AIYAA-1011/buhuiqiming_srm-car/docs/PPT文字索引.md

# 最终交付PPT文字索引

> 原件名为“不晦启明队_ 最终交付.pptx”，内含中期结构材料和过程页面。以下按原页序提取，保留历史表述，不作为最终实装或最终规则验收依据。最新状态见[最终交付说明](最终交付.md)。

## 第1页

结构组中期汇报

不晦启明队

结构组  顾翊天 周汐玥 
汇报进度截至 2026年10月16日

低矮麦轮底盘与折返机械臂

移动对位、矿石抓取与递交的结构方案

01 / 15

## 第2页

底盘整体布局

不晦启明队  结构组

电池

控制板

存矿区域

图示未完全配合，夹取舵机尚未收纳

碳纤维承载式底板

底板约250 × 310 × 5 mm
低矮布置，设计离地间隙约5 mm

电子器件尽量水平铺开

利用底盘平面空间，减少上下叠放
给主臂折叠和线束留出垂向空间

轮组与臂组共同布局

轴距约250 mm，肩部靠近作业侧后缘
控制板、电池与存矿区分开安排

结构组中期汇报

## 第3页

底板镂空与矿石避让

不晦启明队  结构组

肩轴中心

矿石靠近此侧

作业侧后缘

肩部中心靠近后缘，缩短向车外夹取的距离

1

2

3

4

1  电池绑带固定孔

穿过绑带，限制电池移动

2  舵机收纳孔

夹爪放平后，为下置舵机让位

3  控制板过线孔

线束穿板，便于控制板与执行器连接

4  弧形矿石避让口

R75弧口为矿石保留避让空间

结构组中期汇报

## 第4页

麦轮底盘的移动与对位

不晦启明队  结构组

04 / 15

向作业端前进

向左平移

逆时针转向

俯视图，三角标记为作业端

轮旁箭头表示各轮滚动驱动方向，反向运动时四轮箭头全部反向

结构组中期汇报

## 第5页

机械臂设计与关节运动

不晦启明队  结构组

05 / 15

R1 肩部俯仰

R2 肘部俯仰

R3 末端俯仰

R4 绕臂长轴自转

G1 夹取开合

夹持矿石中间细腰

删除底座回转

减少根部轴系和高度堆叠
车身转向部分承担朝向调整

肩肘舵盘直连

不另设外置带轮或齿轮减速级
主臂采用PLA打印主体

折返与末端自转收纳

将夹取舵机转入底盘凹槽
保留必要动作，控制占用空间

R1 / R2：主臂设计    R3 / R4 / G1：夹爪动作接口

结构组中期汇报

## 第6页

装配方式与顺序

不晦启明队  结构组

06 / 15

01 电机固定板

02 肩部舵盘

03 爪组接口

01  底板与轮组

按计划攻丝后锁螺钉
先定位电机固定板，再装轮组

02  肩根与双轴舵机

安装肩部固定块，校正转轴方向
主、副舵盘连接两侧臂板

03  肘部与夹爪接口

先调舵机零位，再锁紧臂段
接入爪组，检查全行程避让

04  复查与动作验证

螺纹与防松、同轴性、轮组方向
线束余量和低速空载动作

结构组中期汇报

## 第7页

过洞收纳与通行

不晦启明队  结构组

07 / 15

点击视频播放  无声

结构组中期汇报

## 第8页

不同矿石姿态的夹取

不晦启明队  结构组

08 / 15

1

竖立与侧躺工况

2

都夹持中间细腰

3

侧躺时上方接近

4

抬升并收回

点击视频播放  无声

结构组中期汇报

## 第9页

一二三级兑换姿态

不晦启明队  结构组

09 / 15

1

矿石固定在爪内

2

腕部俯仰联动

3

车身调整方位

4

吸附松爪后退出

点击视频播放  无声

结构组中期汇报

## 第10页

分工、进度与后续安排

不晦启明队  结构组

10 / 15

实物展示

截至10月16日

全部零件已加工
整车部分装配（一些零件配不上稍作更改）
功能尚未实机验证

顾翊天

底盘、主臂及其余结构
零件采购与装配

周汐玥

夹爪夹取、旋转与俯仰三轴
夹爪机构装配

后续计划

辅助电控组调试并完成组装

结构组中期汇报

## 第11页

三种姿态与尺寸边界

答辩备份

11 / 15

开局收纳

约371 × 388 × 151 mm

过洞收纳

收纳高度小于70 mm

作业姿态

肩肘展开，末端按任务对位

规则边界：初始400 × 400 × 400 mm，伸展800 × 800 × 800 mm，整车≤6 kg

新收纳高度小于70 mm由队员确认；开局尺寸另为旧CAD几何候选，需装配复核。

结构组中期汇报

## 第12页

底板与关节连接细节

答辩备份

12 / 15

底板孔位与局部镂空

计划连接方式

碳板直接攻丝后锁螺钉
电机固定板与肩部固定块先定位
双轴舵机主、副舵盘连接两侧臂板

装配时重点复查

转轴方向与两侧连接是否同轴
舵盘锁紧前是否完成初始位置校正
碳板螺纹的承载、边距与防松
打印孔位、舵机壳体与线束避让

图示孔位来自CAD，实际锁紧与防松能力需装配确认。

结构组中期汇报

## 第13页

关节范围与舵机选型假设

答辩备份

13 / 15

关节 | 选型与角度 | 静态重力矩估算 | 名义换算 条件值

肩部俯仰 | 30等级 270° | 1.30–1.48 N·m | 2.94 N·m

肘部俯仰 | 25等级 270° | 0.79–0.90 N·m | 2.45 N·m

末端三轴 | 15等级 标注360° | 本页不作独立校核 | 角度标注不等于无限回转

估算前提

矿石20 g；PLA密度1.24 g/cm³
有效打印体积取65%至100%作敏感性比较
大舵机按75 g、小舵机按60 g估计

结论边界

若30 / 25的单位为kgf·cm，才作表中换算
未计加速度、冲击、摩擦及全部紧固件
静态估算不能证明连续工作与结构可靠性

结构组中期汇报

## 第14页

开源借鉴与再设计归类

答辩备份

14 / 15

充分再设计

删除底座回转轴
肩肘舵盘直连，精简传动

非充分再设计

轮距、轴距调整
电子器件平铺与执行器选型

无效再设计

碳纤维底板选材
PLA打印主体与外形适配

参考串联堆叠与折叠布局，没有直接照搬零件或完整尺寸

结构组中期汇报

## 第15页

兑换条件与可达性核对

答辩备份

15 / 15

难度 | z mm | θ ° | φ ° | 单次得分 | 解锁条件

一级 | 280.5 | 90 | 90 | 1 | 无需解锁

二级 | 100–200 | 30–60 | 90 | 10 | 一级完成1次

三级 | 100–200 | 30–60 | 90–120 | 20 | 二级累计完成2次

动画采用的代表位姿

一级 280.5 / 90 / 90
二级 200 / 45 / 90
三级 200 / 45 / 105

完成兑换的关键条件

裁判宣布可以兑换后递矿
尾孔与圆柱配合，吸附后释放夹爪
随兑换站到达退矿位姿且不掉落才判成功

腕部俯仰联动，夹持点按CAD估算；接触与三维碰撞仍需实物验证。

结构组中期汇报

## 第16页

电控部分

## 第17页

图表 1 MCU

图表 2 电机驱动模块

电控部分

## 第18页

图表 1 MCU

图表 2 电机驱动模块

电控部分

车控采用：
stm32f103rct6

## 第19页

图表 1 MCU

图表 2 电机驱动模块

电控部分

车控采用：
stm32f103rct6

遥控采用：
stm32f103c8t6

均包含复位电路

## 第20页

图表 3 电源管理模块

图表 4 舵机驱动模块

电控部分

## 第21页

图表 3 电源管理模块

图表 4 舵机驱动模块

电控部分

图表 2 电机驱动模块

## 第22页

图表 3 电源管理模块

图表 4 舵机驱动模块

电控部分

图表 2 电机驱动模块

12V / 1800mAh电池

2mΩ采样电阻＋INA226

VM_12V母线

4×DRV8874

四个电机

2×XL4015

五个舵机

LM2596-5.0

STM32、nRF、INA226等

车控电源方案

12V->5V->3.3V

电池持续电流只有4A!!!

12V->6V

## 第23页

图表 3 电源管理模块

图表 4 舵机驱动模块

电控部分

图表 2 电机驱动模块

车控电源方案

电池持续电流只有4A!!!

## 第24页

图表 3 电源管理模块

图表 4 舵机驱动模块

电控部分

图表 2 电机驱动模块

车控电源方案

电池持续电流只有4A!!!

## 第25页

图表 3 电源管理模块

图表 4 舵机驱动模块

电控部分

图表 2 电机驱动模块

车控电源方案

电池持续电流只有4A!!!

## 第26页

图表 3 电源管理模块

图表 4 舵机驱动模块

电控部分

图表 2 电机驱动模块

## 第27页

图表 4 舵机驱动模块

电控部分

图表 2 电机驱动模块

30KG

25KG

MG945

MG945

MG945

机械臂选型：

汽车底盘

## 第28页

图表 4 舵机驱动模块

电控部分

图表 2 电机驱动模块

风险点：五只舵机不能同时快速启动
选型：PCA9685

可以输出多路舵机PWM。
只占用MCU两根I²C信号线。

## 第29页

图表 4 舵机驱动模块

电控部分

图表 2 电机驱动模块

四路电机独立驱动，可以分别进行速度闭环。

公共MOTOR_EN可以在急停或失联时快速关闭全部电机

## 第30页

图表 5 无线通讯模块

图表 6  oled模块

电控部分

通信选型：Si24R1

显示电压、电流、功率和剩余电量

## 第31页

图表 7 蜂鸣器和急停

图表 8 串口调试模块

电控部分

提示上电、失联、欠压和急停

通知MCU立即停止所有动作

## 第32页

图表 8 串口调试模块

电控部分

## 第33页

电控部分

## 第34页

电控部分

## 第35页
