AIYAA-1011/buhuiqiming_srm-car/software/P02_remote_hal/遥控器说明.md

# P02 遥控器 功能说明

| 项目 | 内容 |
|---|---|
| 工程名称 | `P02_remote_hal` |
| 设备类型 | 麦轮小车遥控器（手持端） |
| 主控 | STM32F103C8T6 |
| 软件平台 | STM32 HAL + FreeRTOS |
| 开发工具 | Keil MDK-ARM V5.32 |
| 文档版本 | v1.0 |
| 编码 | UTF-8 |

---

## 目录

1. [概述](#1-概述)
2. [硬件资源](#2-硬件资源)
3. [软件架构](#3-软件架构)
4. [功能说明](#4-功能说明)
5. [对外接口：无线数据帧](#5-对外接口无线数据帧)
6. [显示界面](#6-显示界面)
7. [操作流程](#7-操作流程)
8. [参数配置](#8-参数配置)
9. [调试接口](#9-调试接口)

---

## 1. 概述

本设备为麦轮小车系统的**手持遥控端**，负责采集操作者的摇杆与按键输入，经处理后通过 2.4G 无线链路发送至小车端。

**设计原则**

遥控器端仅完成「输入采集 → 数值归一化 → 打包发送」以及本机状态显示，**不承担任何运动学解算、关节映射与执行器限位**。此类计算由小车端依据本机发送的轴值与标志位完成。

**主要功能一览**

| 类别 | 功能 |
|---|---|
| 输入 | 4 轴摇杆采集、6 键非阻塞扫描 |
| 处理 | 归一化（分段）、极性修正、限幅、死区与重新拉伸 |
| 控制 | 底盘 / 机械臂模式切换、三个预设姿态、急停、夹爪 |
| 安全 | 回中解锁、急停冻结输出 |
| 校准 | 双层窗口中位校准、中位 Flash 持久化 |
| 通信 | 常驻发送、17 字节定长帧、约 90 Hz |
| 诊断 | 无线链路成功率统计、串口调试输出 |
| 显示 | 128×64 OLED 状态显示 |

---

## 2. 硬件资源

### 2.1 主控与时钟

| 项目 | 参数 |
|---|---|
| MCU | STM32F103C8T6，LQFP48，64 KB Flash / 20 KB SRAM |
| 系统时钟 | 72 MHz（HSE 8 MHz × PLL9） |
| ADC 时钟 | 12 MHz（PCLK2 / 6） |
| 调试接口 | SWD（PA13 / PA14） |

### 2.2 外设分配

| 外设 | 配置 | 用途 |
|---|---|---|
| ADC1 | 4 通道扫描、连续转换、12 位 | 摇杆采集 |
| DMA1_CH1 | 循环模式、半字、外设→存储器 | ADC 数据搬运（不占用 CPU） |
| SPI1 | 主机、全双工、8 位、9 Mbps、软件 NSS | SI24R1 无线模块 |
| USART1 | 115200 8N1 | 调试日志输出 |
| SysTick | 1 kHz | FreeRTOS 时基 |

> SPI1 使用了引脚重映射（`AFIO_MAPR`），实际引脚为 PB3 / PB4 / PB5。

### 2.3 引脚分配

**摇杆（模拟输入）**

| 轴 | 物理位置 | 引脚 | ADC 通道 |
|---|---|---|---|
| `ly` | 左摇杆 上下 | PA1 | ADC1_IN1 |
| `lx` | 左摇杆 左右 | PA6 | ADC1_IN6 |
| `ry` | 右摇杆 上下 | PA2 | ADC1_IN2 |
| `rx` | 右摇杆 左右 | PA3 | ADC1_IN3 |

**按键（输入，内部上拉，低电平有效）**

| 按键 | 引脚 |
|---|---|
| `UP` | PB11 |
| `DOWN` | PB14 |
| `LEFT` | PB13 |
| `RIGHT` | PB12 |
| `LEFT_X` | PB2 |
| `RIGHT_X` | PB10 |

**无线模块 SI24R1**

| 信号 | 引脚 |
|---|---|
| SCK / MISO / MOSI | PB3 / PB4 / PB5 |
| 片选 NSS | PA15 |
| 使能 CE | PB7 |

**OLED 显示（软件模拟 SPI）**

| 信号 | 引脚 |
|---|---|
| CS / SCLK / SDIN | PA4 / PA5 / PA7 |
| RST / DC | PB0 / PB1 |

**其他**

| 信号 | 引脚 | 说明 |
|---|---|---|
| 调试串口 TX / RX | PA9 / PA10 | 115200 8N1 |
| 电源管理键 | PB15 | 周期模拟按键，抑制 IP5305T 自动关机 |

---

## 3. 软件架构

### 3.1 任务划分

系统运行于 FreeRTOS（tick 频率 1000 Hz，`heap_4` 堆 12 KB，优先级 0~4）。

| 任务 | 周期 | 优先级 | 职责 |
|---|---|---|---|
| `power_task` | 3 s | 4 | 周期触发电源芯片按键，抑制自动关机 |
| `com_task` | 10 ms | 3 | 组帧并发送 |
| `key_task` | 20 ms | 2 | 按键扫描、命令状态维护、回中解锁判定 |
| `joy_task` | 20 ms | 2 | 摇杆采集与轴处理 |
| `oled_task` | 100 ms | 1 | 屏幕刷新 |

### 3.2 模块划分

| 层次 | 文件 | 职责 |
|---|---|---|
| 硬件接口层 | `Int_joystick.c` | 摇杆 ADC 采集（DMA） |
| | `Int_key.c` | 按键非阻塞扫描 |
| | `Int_SI24R1.c` | 无线模块驱动 |
| | `Int_IP5305T.c` | 电源管理 |
| | `Inf_OLED.c` / `Inf_font.c` | OLED 驱动与字库 |
| 应用层 | `App_process_data.c` | 轴处理链、中位校准与持久化 |
| | `App_command.c` | 按键事件 → 命令状态、回中解锁 |
| | `App_transmit_data.c` | 组帧、发送、链路统计 |
| | `App_display.c` | 界面刷新 |
| | `App_freeRTOS_Task.c` | 任务创建与调度 |
| 公共层 | `Com_debug.c` | 日志输出重定向 |
| | `Com_tool.c` | 通用工具函数 |

---

## 4. 功能说明

### 4.1 摇杆采集与轴处理

**采集**：ADC1 以 4 通道扫描 + 连续转换方式工作，转换结果由 DMA1_CH1 循环写入缓冲区 `adc_buff[4]`，全过程不占用 CPU。

**处理链**（每 20 ms 执行一次）：

| 步骤 | 处理 | 说明 |
|---|---|---|
| 1 | ADC → 命令值 | **以标定中位为锚点，两侧各自归一化**（见下） |
| 2 | 极性修正 | 由配置宏 `AXIS_INV_*` 决定是否反相 |
| 3 | 限幅 | 限制在 −500 ~ +500 |
| 4 | 死区 | 绝对值小于**该轴**死区半宽时输出 0（默认 `AXIS_DEADZONE`，`ly` 单独用 `AXIS_DEADZONE_LY`） |
| 5 | 死区外重新拉伸 | 使输出自 0 平滑增长，避免死区边缘跳变 |

**死区可以按轴单独设置**

| 宏 | 值 | 轴 |
|---|---|---|
| `AXIS_DEADZONE` | 50 | 默认值，`lx` / `ry` / `rx` 都用它 |
| `AXIS_DEADZONE_LY` | **100** | `ly`（左杆上下 = 机械臂大臂）单独加大 |

`ly` 单独加大的原因：这根杆回中的一致性比其它轴差一些，死区太小时松手后大臂会自己慢慢爬。

**加大的代价只是"中位附近一段行程不响应"**——死区外会重新拉伸，所以**推到底仍然是满量程 ±500，不会丢极速**，只是中段手感变"钝"。实测（`raw_mid=1974`、`raw 0..4020`）：

| 死区 | 死区宽度（原始 ADC 计数） | 推到底 | 60% 行程时的输出 |
|---|---|---|---|
| 50 | 201 / 208 | ±500 | +277 |
| **100** | **398 / 413** | ±500 | **+250** |
| 150 | 596 / 617 | ±500 | +214 |
| 200 | 793 / 822 | ±500 | +166 |
| 300 | 1188 / 1231 | ±500 | +0（要推过 60% 才开始有输出） |

所以**不要超过 200 左右**，再大就变成"大半段行程没反应"了。

**第 1 步的分段归一化**

```c
正方向： raw_mid -> raw_lo   映射到   0 -> +500
负方向： raw_mid -> raw_hi   映射到   0 -> -500
```

- `raw_mid` 是校准得到的**中位**原始 ADC
- `raw_lo` / `raw_hi` 是**实测自学习**得到的两个端点原始 ADC（见 [4.8.1](#481-端点自学习)）

> **为什么不做成"整量程线性换算 −500~+500，再减一个零偏"**：那种做法只能把整条曲线**平移**。中位一旦偏离电气中点（2048），偏的那一侧就被白白吃掉一截量程——实测中位 1974 时正半轴只能到 **+480**，而负半轴被限幅削到 −500 反而看不出问题。
>
> **为什么端点也不能写死成 0 / 4095**：电位器不一定真能推到 ADC 的两条轨上。实测本机遥控器正方向 `raw` 能到 **0**，负方向只到 **约 4020**。端点写死 4095 的话，负方向最多只能到 **−480**。
>
> 中位和端点都用实测值之后，**不管中位落在哪里（1900 / 1974 / 2048 / 2100 …）、也不管电位器行程差多少，推到底都是精确的 ±500**，正反两个方向的灵敏度也对称。

**输出语义**

```
值域： −500 ~ +500
中位： 0（= 停止）
符号： 负值 = 反方向，正值 = 正方向
幅值： 速度 / 角速度的归一化大小
```

四个轴的输出存放于全局数组 `axis_value[4]`，顺序为 `ly / lx / ry / rx`。

### 4.2 按键输入

按键扫描为**非阻塞**实现：每 20 ms 读取一次全部 6 个引脚，拼装为位掩码返回，函数内部不含任何等待循环。

- **去抖**：要求连续 2 次读数一致
- **边沿检测**：由应用层计算上升沿（刚按下）与下降沿（刚松开）
- **长短按**：以按下时刻的时间戳判定，判定期间不阻塞其它按键

按键功能分配见下表：

| 按键 | 功能 | 触发方式 |
|---|---|---|
| `UP` | 急停 | 锁定式：按一下锁定，再按一下解除 |
| `LEFT` | 预设「过洞」 | 按一下触发，再按一下取消 |
| `RIGHT` | 预设「取矿」 | 同上 |
| `DOWN` | 预设「兑矿」 | 同上 |
| `LEFT_X` | 切换 底盘 / 机械臂 模式 | 按下即切换 |
| `RIGHT_X`（短按） | 夹爪开合 | 按下时长 < 1 s |
| `RIGHT_X`（长按） | 请求重新校准摇杆 | 按下时长 > 1 s |

### 4.3 控制模式

设备具有两种控制模式，由 `LEFT_X` 键切换：

| 模式 | 四个轴的语义 |
|---|---|
| **底盘模式** | `ry` 前后 / `rx` 左右 / `lx` 自转 / `ly`（不使用，固定发 0） |
| **机械臂模式** | `ly` 大臂 / `lx` 小臂 / `ry` 腕部俯仰 / `rx` 腕部转动 |

当前模式通过数据帧的标志位（bit2）发送。

### 4.4 预设姿态

提供三个预设姿态，均以**互斥锁存位**方式发送：

| 预设 | 触发键 |
|---|---|
| 过洞 | `LEFT` |
| 取矿 | `RIGHT` |
| 兑矿 | `DOWN` |

**启动条件**：当前没有其它预设处于激活状态。

**取消条件**（任一满足即清空预设位）：

1. 再次按下同一按键
2. 任意摇杆离开中位（操作员接管）
3. 按下急停
4. 解除急停

**互锁**：已经有预设时，按**别的**预设键**无效**——该次按键被忽略，同时屏幕行 1 最右一格的状态字母**闪烁 2 下**（约 800 ms）作为反馈。

必须先取消当前预设，才能启动另一个。取消的推荐方式是**按同一个键**；推摇杆虽然也能取消，但在机械臂模式下会同时让机械臂动作，不建议用来做"确认取消"。

> **为什么要互锁**：一个预设是一整套机械臂（和底盘）动作序列。若执行到一半被另一个预设顶掉，机械臂会从当前姿态直接拐向新轨迹，带着矿石时容易把矿甩掉或撞到结构。

**语义**：预设位为**电平**，每帧持续发送；接收侧依据 `0 → N`（开始执行）和 `N → 0`（中止）两种状态跳变识别意图。

由于互锁的存在，**正常操作下不会出现 `M → N` 的直接切换**（中间一定会经过全 0）。

### 4.5 急停

由 `UP` 键控制，采用**锁定式**语义：

| 状态 | 行为 |
|---|---|
| 激活（按一下） | 四个轴强制输出 0；预设位清空；预设按键不响应；屏幕显示反白字母 `E` |
| 解除（再按一下） | 清除急停位，同时进入「冻结」状态，要求摇杆回中后方可恢复输出 |

### 4.6 夹爪

由 `RIGHT_X` 短按翻转，状态通过标志位（bit1）以**电平**方式每帧发送。

### 4.7 回中解锁（安全机制）

**触发条件**：上电、切换模式、解除急停、请求重新校准。

**行为**：设备进入「冻结」状态，四个轴一律输出 0；待四个摇杆全部回到中位后自动解锁并恢复输出。

**设计目的**：避免模式切换瞬间将上一模式的摇杆位置当作新模式的命令发出。例如在底盘模式下持续前推右摇杆时切换至机械臂模式，若无此机制，腕部关节将按当前摇杆位置立即动作。

### 4.8 摇杆校准与中位持久化

**校准方式**：双层窗口判定

| 层次 | 条件 | 说明 |
|---|---|---|
| 第一层（精准） | 四个轴全部进入死区（屏幕显示 `----`） | 中位直接落在死区中心附近，效果最好 |
| 第二层（保底） | 进入冻结状态满 5 s 后仍未满足第一层，窗口放宽 | 防止电位器机械中位偏差过大时设备无法解锁 |

第二层进入时串口输出 `CALIB: wide window fallback`。

**校准流程**：连续采样 10 次（共约 100 ms）取平均，把得到的**原始 ADC** 定义为该轴中位，并写入 Flash 保存。

> 校准存的是**原始 ADC**（数值在 2000 附近），不是换算后的命令值。命令值域会随中位移动，只有原始 ADC 才是稳定的锚点。

**中位合法性检查**：四个轴的中位原始 ADC 必须全部落在 `AXIS_MID_MIN`(1300) ~ `AXIS_MID_MAX`(2750) 之间。

- 任一轴越界 → **本次校准整体拒绝**，不写 Flash、不解锁，串口输出 `CALIB REJECT: axis N mid=... 不在 [...] 内`，并重新开始 5 s 计时。
- 同时要求中位到两个端点的距离都不小于 `AXIS_MIN_HALF_RANGE`(600) 计数，否则报 `行程太短`。
- 从 Flash 读回时也做同样的检查；越界则视为无有效数据，要求重新校准。

范围取得比较宽，是为了不误伤"电位器机械中位本来就偏"的摇杆——宁可让某个轴的灵敏度左右略有差异，也不能让遥控器永远解不了锁。

#### 4.8.1 端点自学习

**为什么需要**：电位器的电气行程不一定铺满 ADC 的 0 ~ 4095，两端也可能不对称。实测本机遥控器：

| 方向 | 实测 `raw` 端点 |
|---|---|
| 正方向 | 能顶到 **0**（ADC 饱和） |
| 负方向 | 只到 **约 4020**，到不了 4095 |

所以端点必须在运行时实测。

**做法**：`joy_task` 每 20 ms 记录每个轴**真的见过**的最小 / 最大 `raw`，但只有"推得够深"才认账：

| 常量 | 值 | 含义 |
|---|---|---|
| `AXIS_END_LO_MAX` | 600 | 实测 `raw` 小于它，才算"正方向真的推到底了" |
| `AXIS_END_HI_MIN` | 3500 | 实测 `raw` 大于它，才算"负方向真的推到底了" |
| `AXIS_END_LO_DEFAULT` | 0 | 还没学到时的保底值 |
| `AXIS_END_HI_DEFAULT` | 4095 | 还没学到时的保底值 |
| `AXIS_WARMUP_SAMPLES` | 50 | 开机前 1 秒不学习（DMA 初值还是 0） |

生效端点 = 实测值（够深时）／保底值（不够深时）。护栏的作用是防止噪声或半程推杆把量程撑坏。

**持久化**：学到的极值会在**静默 2 秒后**自动写一次 Flash（`AXIS_END_SAVE_QUIET` = 100 拍）。只在已经成功校准过之后才会写；写一次标志就清零，加上 `calib_save()` 自身的内容比对，所以不会反复擦写。

> 所以正常情况下**不需要任何额外操作**：上电后推一两次杆顶到底，端点就学到了，并且会记住。

**中位持久化**

| 项目 | 内容 |
|---|---|
| 存储位置 | Flash 末页 `0x0800FC00`（1 KB 页，程序未占用） |
| 数据格式 | magic（2 B）+ 4 轴 × 3 个 int16（中位 / 见过的 min / 见过的 max，共 24 B）+ 异或校验（2 B） |
| 记录长度 | 14 个半字（28 B） |
| magic 值 | `0x5A5C` |
| 上电行为 | 读取有效则直接应用，跳过采样校准，端点也直接可用 |
| 写入时机 | 校准成功后；以及端点自学习到新极值后静默 2 秒 |
| 优化 | 数据与 Flash 中一致时跳过擦写 |

> **magic 变迁**：`0x5A5A`（最初的"命令域零偏"）→ `0x5A5B`（"原始 ADC 中位"，6 半字）→ **`0x5A5C`（"中位 + 两端点"，14 半字）**。不换 magic 的话旧数据会被按新格式误读，算出乱七八糟的量程。**所以每次升级格式后第一次上电都会要求重新校准一次，这是预期行为。**

### 4.9 无线通信

| 项目 | 内容 |
|---|---|
| 模块 | SI24R1（nRF24L01 兼容） |
| 工作模式 | **常驻发送**：上电配置一次，运行期间不再切换 |
| 通信方向 | 单向发送，不等待任何回复 |
| 同步要求 | 无（无需与接收端对齐周期或相位） |
| 发送周期 | 10 ms（含发送耗时，实际约 90 Hz） |

### 4.10 链路质量统计

利用无线模块的**硬件自动应答（Auto-ACK）**机制统计发送成功率：

- 每发送一帧，接收端无线芯片自动回复 ACK 包
- 发送函数返回成功即代表接收端已收到该帧
- 每 50 次发送结算一次，结果显示为屏幕上的 `LNK xx%`

该功能不增加任何额外通信开销，亦无需接收端软件配合。

> **适用边界**：ACK 由接收端的无线芯片产生，不依赖其主控程序，因此该指标反映「接收端无线模块在线且配置正确」，不能反映其主控运行状态。

### 4.11 电源管理

`power_task` 每 3 秒将电源管理芯片（IP5305T）的 KEY 引脚拉低 100 ms，模拟一次按键动作，抑制芯片的无操作自动关机。任务启动时立即执行一次，避免开机后等待首个周期期间被关机。

### 4.12 调试输出

调试日志通过 USART1（115200 8N1）输出，格式为 `[文件名:行号] 内容`。系统提供三级开关，详见[第 9 节](#9-调试接口)。

---

## 5. 对外接口：无线数据帧

### 5.1 无线参数

| 参数 | 值 |
|---|---|
| 通信地址 | `0x0A 0x01 0x06 0x1E 0x01`（5 字节） |
| 射频信道 | 40 |
| 空中速率 | 1 Mbps |
| 有效载荷宽度 | 17 字节 |
| CRC | 16 位使能 |
| 自动应答 | 通道 0 使能 |
| 自动重发 | 10 次，间隔 250 µs |

### 5.2 帧格式

**帧长固定 17 字节**，多字节字段均为**大端序**。

| 字节 | 字段 | 类型 | 说明 |
|---|---|---|---|
| `[0..2]` | 帧头 | — | `0x73 0x67 0x67`（`'s' 'g' 'g'`） |
| `[3..4]` | `ly` 左杆上下 | int16 | −500 ~ +500 |
| `[5..6]` | `lx` 左杆左右 | int16 | −500 ~ +500 |
| `[7..8]` | `ry` 右杆上下 | int16 | −500 ~ +500 |
| `[9..10]` | `rx` 右杆左右 | int16 | −500 ~ +500 |
| `[11]` | 命令标志位 | bitfield | 见 5.3 |
| `[12]` | 预留 | uint8 | 恒为 0 |
| `[13..16]` | 校验和 | uint32 | `[0..12]` 共 13 字节之和 |

**轴值说明**

- 有符号 16 位，负数以**二进制补码**表示，无偏置
- `0` 表示中位（停止），正负号表示方向
- 当设备处于**冻结**（未解锁）或**急停**状态时，四个轴一律为 0
- 底盘模式下 `ly` 固定为 0

### 5.3 命令标志位（byte 11）

| 位 | 名称 | 语义 |
|---|---|---|
| 0 | `ESTOP` | 1 = 急停锁定中 |
| 1 | `GRIPPER` | 1 = 夹爪夹紧，0 = 张开 |
| 2 | `MODE` | 0 = 底盘模式，1 = 机械臂模式 |
| 3 | `PRESET_HOLE` | 过洞 |
| 4 | `PRESET_PICK` | 取矿 |
| 5 | `PRESET_PUT` | 兑矿 |
| 6~7 | 保留 | — |

**约定**

- bit3 ~ bit5 **互斥**，同一时刻至多一位为 1；全 0 表示「无预设 / 已取消」
- 全部标志位均为**电平语义**：每帧发送当前完整状态，不做「发送后清零」
- 预设位依赖**状态跳变**被识别：`0 → N` 表示开始执行，`N → 0` 表示中止
- 由于遥控器端的互锁（见 [4.4](#44-预设姿态)），**接收端正常不会收到 `M → N` 的直接切换**（中间必定经过一次全 0）。接收端仍建议保留对 `M → N` 的容错处理，以应对丢帧错序

### 5.4 校验和

取 `[0]` ~ `[12]` 共 13 字节的算术和，以大端 32 位写入 `[13..16]`。

### 5.5 发送时序

设备上电后即进入持续发送状态，`com_task` 以 10 ms 周期组帧并发送，实际帧率约 90 Hz，无握手、无应答等待、无重传同步。

### 5.6 示例帧

**场景**：机械臂模式、夹爪夹紧、预设为「取矿」、`ly=+500`、`lx=0`、`ry=−120`、`rx=+30`

| 下标 | 0 | 1 | 2 | 3 | 4 | 5 | 6 | 7 | 8 | 9 | 10 | 11 | 12 | 13 | 14 | 15 | 16 |
|---|---|---|---|---|---|---|---|---|---|---|---|---|---|---|---|---|---|
| Hex | 73 | 67 | 67 | 01 | F4 | 00 | 00 | FF | 88 | 00 | 1E | 16 | 00 | 00 | 00 | 03 | F1 |

- `ly = +500 = 0x01F4`
- `ry = −120 → 0xFF88`（补码）
- `rx = +30 = 0x001E`
- 标志位 `0x16 = 0b0001_0110` → bit1（夹爪）+ bit2（机械臂）+ bit4（取矿）
- 校验和 `1009 = 0x000003F1`

---

## 6. 显示界面

显示器件为 128×64 OLED，采用 8×12 点阵 ASCII 字体，每行 16 字符，共 4 行。

### 6.1 开机自检

| 顺序 | 内容 | 说明 |
|---|---|---|
| 1 | `STG REMOTE` / `BOOTING...` | 启动提示 |
| 2 | `RF CHECK` / `RF OK` 或 `RF FAIL` | 无线模块自检结果 |
| 3 | `CENTER STICKS` | 提示将摇杆置于中位 |

自检失败（`RF FAIL`）时设备仍继续启动，以便操作者获知故障原因。

### 6.2 正常界面（已解锁）

```
底盘模式                        机械臂模式
LNK  98%         E              LNK  98%         P
MECANUM READY                   ARM READY
-- ----  VX +512                BM +512  WP ----
W  +200  VY ----                EX ----  WR ----
```

| 位置 | 内容 |
|---|---|
| 行 1 左侧 | 无线链路成功率 `LNK xx%`；无成功记录时显示 `LNK --` |
| 行 1 最右一格 | 状态字母，同一时刻仅显示一个 |
| 行 2 | 当前模式 + 解锁状态（`READY` 已解锁 / `CENTER` 冻结中） |
| 行 3、行 4 左列 | 左摇杆两个轴 |
| 行 3、行 4 右列 | 右摇杆两个轴 |

**状态字母**

| 字母 | 含义 | 显示方式 |
|---|---|---|
| 空格 | 无 | — |
| `H` | 过洞 | 常规 |
| `P` | 取矿 | 常规 |
| `D` | 兑矿 | 常规 |
| `E` | 急停锁定 | **反白显示** |

**轴值标签**

| 模式 | 左列 | 右列 |
|---|---|---|
| 底盘 | `--`（不使用）/ `W`（自转） | `VX`（前后）/ `VY`（左右） |
| 机械臂 | `BM`（大臂）/ `EX`（小臂） | `WP`（腕部俯仰）/ `WR`（腕部转动） |

轴值显示 `----` 表示该轴处于死区内（即输出 0）。

### 6.3 冻结界面（未解锁）

行 3、行 4 改为显示四个**物理摇杆轴**，便于操作者将摇杆置于中位：

```
LNK   --
MECANUM CENTER
LY +120  RY ----
LX ----  RX ----
```

四个轴全部显示 `----` 时自动解锁。

---

## 7. 操作流程

### 7.1 首次上电

| 步骤 | 操作 | 反馈 |
|---|---|---|
| 1 | 开机 | 屏幕依次显示启动提示、`RF OK`、`CENTER STICKS`；屏幕进入 `CENTER` 状态 |
| 2 | 将四个摇杆置于中位 | 四个轴显示 `----` 时自动采样校准 |
| 3 | — | 串口输出 `CALIB MID (raw)`、`CALIB SAVE OK`、`CALIBRATED`、`ARMED`；屏幕转为 `READY` |

### 7.2 常规上电

| 步骤 | 操作 | 反馈 |
|---|---|---|
| 1 | 开机 | 串口输出 `CALIB LOAD: ly mid=... lo=... hi=...`；屏幕进入 `CENTER` 状态 |
| 2 | 将四个摇杆置于中位 | 自动解锁，屏幕转为 `READY` |

### 7.3 重新校准

| 步骤 | 操作 | 反馈 |
|---|---|---|
| 1 | 长按 `RIGHT_X` 超过 1 秒后松开 | 串口输出 `CALIB REQUEST`；中位复位到电气中点；屏幕转为 `CENTER` |
| 2 | 将四个摇杆置于中位 | 重新采样并写入 Flash，随后解锁 |

### 7.4 操作中

| 操作 | 结果 |
|---|---|
| 推动摇杆 | 对应轴值随摇杆位置变化，松手回到中位后输出 0 |
| 按 `LEFT_X` | 切换模式；输出冻结，需摇杆回中后恢复 |
| 按 `LEFT` / `RIGHT` / `DOWN` | 触发或取消对应预设 |
| 按 `RIGHT_X` 短按 | 夹爪开合状态翻转 |
| 按 `UP` | 急停锁定；再按一次解除（需重新回中解锁） |

---

## 8. 参数配置

### 8.1 轴处理参数

| 参数 | 当前值 | 位置 |
|---|---|---|
| `AXIS_SPAN` | 500 | `App_process_data.h` |
| `AXIS_DEADZONE` | 50 | `App_process_data.h` |
| `AXIS_DEADZONE_LY` | **100**（`ly` 单独覆盖） | `App_process_data.h` |
| `AXIS_ADC_FULL` | 4095 | `App_process_data.h` |
| `AXIS_MID_NOMINAL` | 2048 | `App_process_data.h` |
| `AXIS_MID_MIN` / `AXIS_MID_MAX` | 1300 / 2750 | `App_process_data.h` |
| `AXIS_END_LO_DEFAULT` / `AXIS_END_HI_DEFAULT` | 0 / 4095 | `App_process_data.h` |
| `AXIS_END_LO_MAX` / `AXIS_END_HI_MIN` | 600 / 3500 | `App_process_data.h` |
| `AXIS_MIN_HALF_RANGE` | 600 | `App_process_data.h` |
| `AXIS_WARMUP_SAMPLES` | 50 | `App_process_data.h` |
| `AXIS_END_SAVE_QUIET` | 100（100×20ms = 2s） | `App_process_data.c` |
| `AXIS_INV_LY` / `LX` / `RY` / `RX` | 0 | `App_process_data.h` |
| 中位 | 校准所得，存 Flash | `0x0800FC00` |

### 8.2 按键与校准参数

| 参数 | 当前值 | 位置 |
|---|---|---|
| `KEY_LONG_PRESS_MS` | 1000 | `App_command.c` |
| `AXIS_ARM_WINDOW` | 150 | `App_command.c` |
| `ARM_TIGHT_TIMEOUT` | 5000 | `App_command.c` |
| `PRESET_FLASH_TICKS` | 40（40×20ms = 800ms） | `App_command.c` |
| `PRESET_FLASH_PHASE` | 10（10×20ms = 200ms） | `App_command.c` |

### 8.3 通信参数

| 参数 | 当前值 | 位置 |
|---|---|---|
| `COM_TASK_PERIOD` | 10 ms | `App_freeRTOS_Task.c` |
| `LINK_WINDOW_SENDS` | 50 | `App_transmit_data.c` |
| `POWER_TASK_PERIOD` | 3000 ms | `App_freeRTOS_Task.c` |

---

## 9. 调试接口

### 9.1 物理接口

| 项目 | 内容 |
|---|---|
| 接口 | USART1，PA9（TX）/ PA10（RX） |
| 参数 | 115200，8 数据位，1 停止位，无校验，无流控 |
| 接线 | PA9 → USB-TTL 接收端；GND 共地 |

### 9.2 日志开关

| 开关 | 位置 | 控制范围 |
|---|---|---|
| `CMD_DEBUG_LOG` | `App_command.c` | 按键事件与命令状态变化 |
| `AXIS_DEBUG_ADC` | `App_process_data.c` | 摇杆原始 ADC 值及行程极值（每 0.5 s 一行） |
| `DEBUG_LOG_ENABLE` | `Com_debug.h` | **全部**日志输出（总开关） |

将开关置 0 后对应输出被编译期移除，不产生任何运行时开销。

### 9.3 典型日志

**开机**

```
[main.c:105]              Hello remote!
[Int_SI24R1.c:253]        SI24R1 Init Success!
[App_process_data.c:...]  CALIB LOAD: ly mid=1974 lo=0 hi=4020 | lx mid=2035 lo=0 hi=4095
[App_process_data.c:...]              ry mid=2050 lo=0 hi=4095 | rx mid=2041 lo=0 hi=4095
```

> `lo` / `hi` 是自学习记录下来的端点极值；`lo=0`、`hi=4095` 表示该轴还没被推到过尽头（会退回保底端点）。

**校准**

```
[App_process_data.c:...]  CALIB: 中位已复位到电气中点，请把四个杆摆到中位
[App_command.c:87]        CALIB REQUEST - center all sticks
[App_process_data.c:...]  CALIB MID (raw): ly=1974 lx=2035 ry=2050 rx=2041
[App_process_data.c:...]  CALIB END (raw): ly=0..4020 lx=0..4095 ry=0..4095 rx=0..4095
[App_process_data.c:...]  CALIB SAVE OK
[App_command.c:141]       CALIBRATED
[App_command.c:156]       ARMED
```

**校准被拒绝**

```
[App_process_data.c:...]  CALIB REJECT: axis 2 mid=2830 不在 [1300,2750] 内
[App_process_data.c:...]  CALIB REJECT: axis 1 行程太短 (mid=2048 lo=1900 hi=2200)
[App_command.c:148]       CALIB REJECTED - center the sticks
```

**ADC 调试输出**（`AXIS_DEBUG_ADC` = 1 时）

```
ADC 2048 2035 2050 2041 | MIN    0  312  298  305 | MAX 3790 3812 3788 4020 | READY
    END ly    0..3790 | lx  312..3812 | ry  298..3788 | rx  305..4020
```

- `MIN` / `MAX` 两列 = 各轴**真的见过**的最小 / 最大原始 ADC
- `END` 一行 = 加上护栏之后**实际生效**的端点。只有 `MIN ≤ 600` 或 `MAX ≥ 3500` 时才会采用实测值，否则显示保底值 `0 / 4095`

**按键与命令**

```
[App_command.c:192]  KEY DOWN: UP
[App_command.c:215]  ESTOP = 1
[App_command.c:223]  MODE -> ARM (HOLD)
[App_command.c:136]  PRESET -> P
[App_command.c:130]  PRESET -> CANCEL
[App_command.c:244]  PRESET BUSY (P) - cancel it first
[App_command.c:261]  GRIPPER = 1
```

按键名缩写：`UP` / `DOWN` / `LEFT` / `RIGHT` / `L_X`（LEFT_X）/ `R_X`（RIGHT_X）。

---

*文档结束*
