AIYAA-1011/buhuiqiming_srm-car/hardware/README.md

# 硬件版本索引

| 版本 | 状态 | 文件 |
|---|---|---|
| [A版](A-competition/) | 实际参赛使用，含赛前返修和外接无线供电改动 | 原理图与PCB文档与嘉立创eprj文件 |
| [B版](B-unverified/) | 备用设计，未经验证、未用于比赛 | 嘉立创EDA工程（.eprj） |

B版主要调整元件布局与电源铺铜，不将设计改动等同于实测通过。完整实装差异与维修情况见[硬件交付](../docs/硬件交付.md)。
