AIYAA-1011/buhuiqiming_srm-car/deliverables/README.md

# 最终交付资料

| 文件 | 内容 |
|---|---|
| [最终交付.pptx](最终交付.pptx) | 队伍提供的结构、电控图文交付PPT |
| [最终交付_结构报告.docx](最终交付_结构报告.docx) | 结构报告原件，原文件名“Season2027_麦轮小车_中期结构报告.docx” |

文件按最终交付归档统一改名，原件内容未修改；PPT和结构报告仍保留中期设计、阶段进度及旧参数，改名不表示其中全部内容已更新为最终实测。最新实装状态、比赛表现和更正信息见[最终交付与参赛复盘](../docs/最终交付.md)。

A版原理图与PCB已单独整理至[参赛A版目录](../hardware/A-competition/)，B版工程在[备用B版目录（未经验证）](../hardware/B-unverified/)。
