AIYAA-1011/buhuiqiming_srm-car/hardware/A-competition/README.md

# A版：实际参赛

[下载A版嘉立创EDA工程](不晦启明_srm%20A.eprj)

工程原文件归档，上传文件校验一致；归档不代表已将比赛实物的返修和飞线改动全部同步进工程。

[下载A版原理图与PCB](A版_原理图与PCB.docx)

此文件由原仓库根目录的“原理图与PCB.docx”移入并明确命名为A版，文件内容保持不变。A版用于最终比赛，比赛实物另有返修、替代料及无线模块外接3.3V等改动，文档不一定完整反映实装接线。

[硬件图文与实装说明](../../docs/硬件交付.md) · [参赛复盘](../../docs/最终交付.md)
