AIYAA-1011/buhuiqiming_srm-car/原理图与PCB.docx

小车部分：

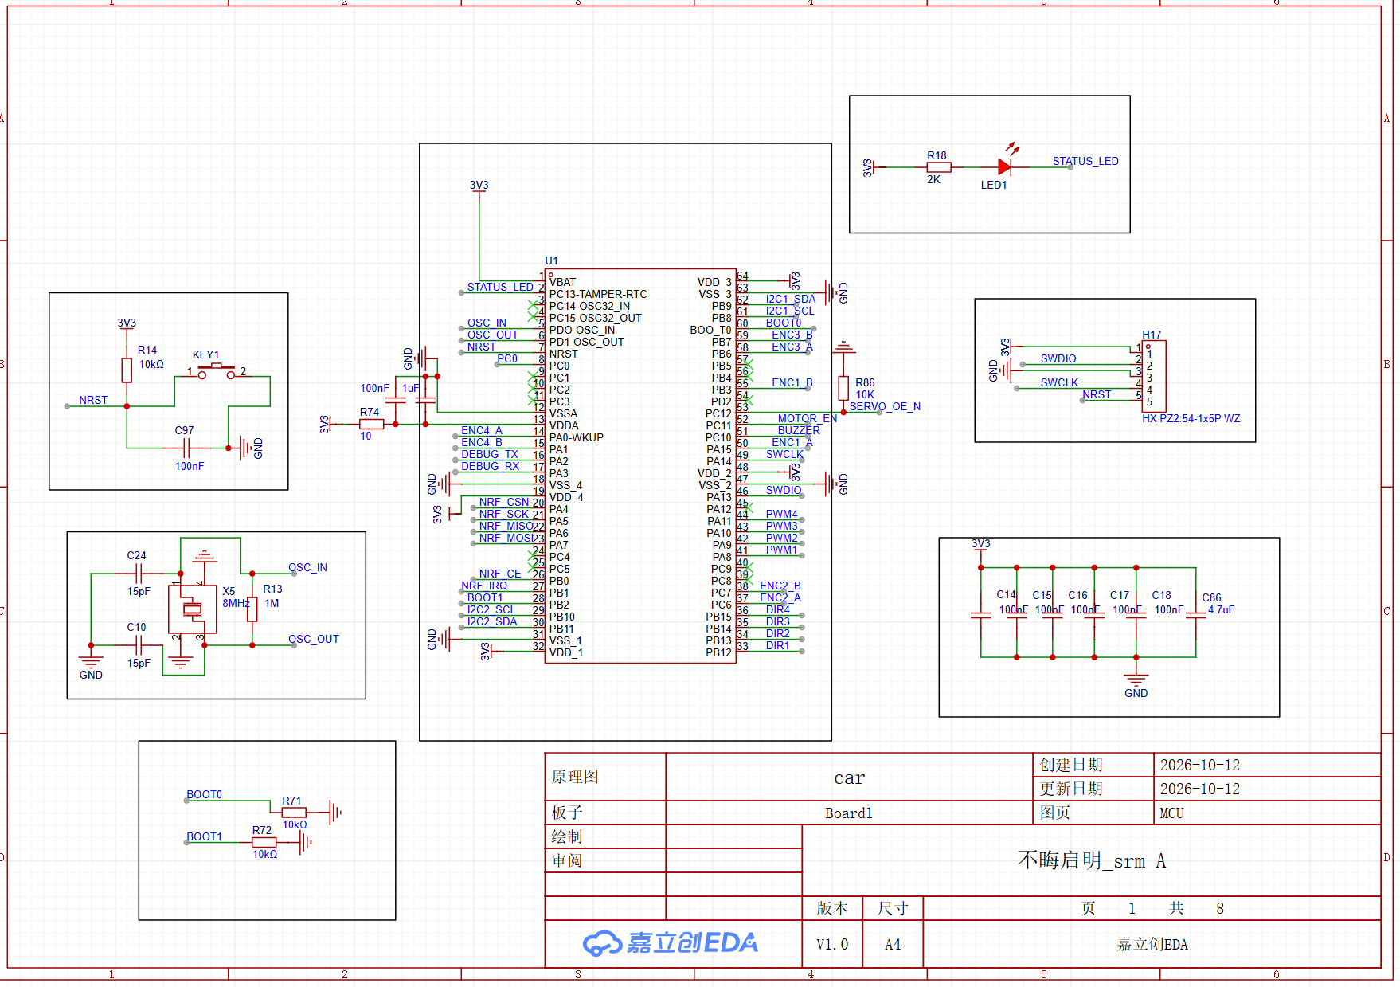
[picture p55: figure]

图表 1 MCU

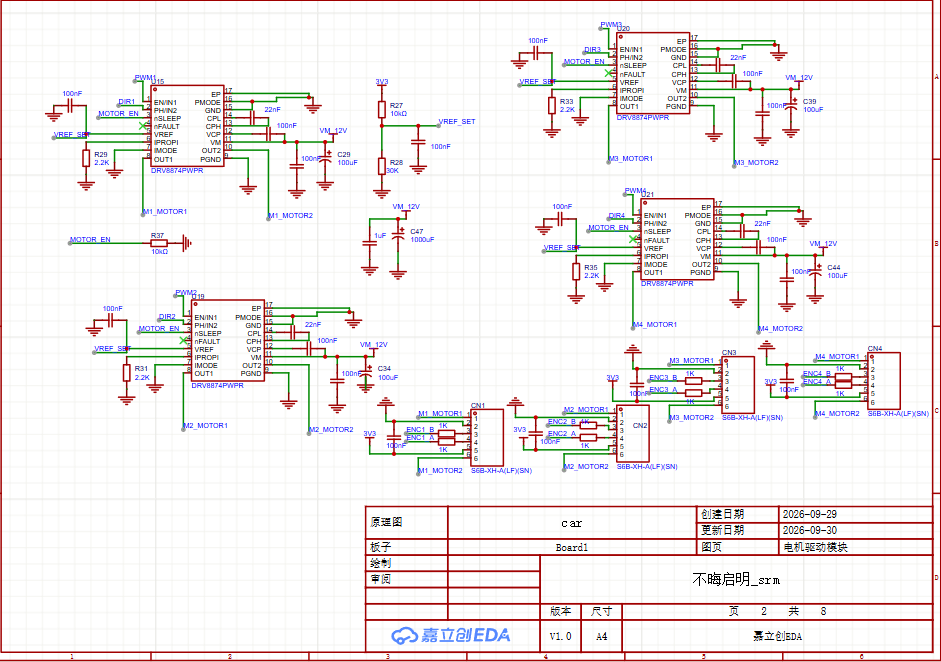
[picture p56: figure]

图表 2 电机驱动模块

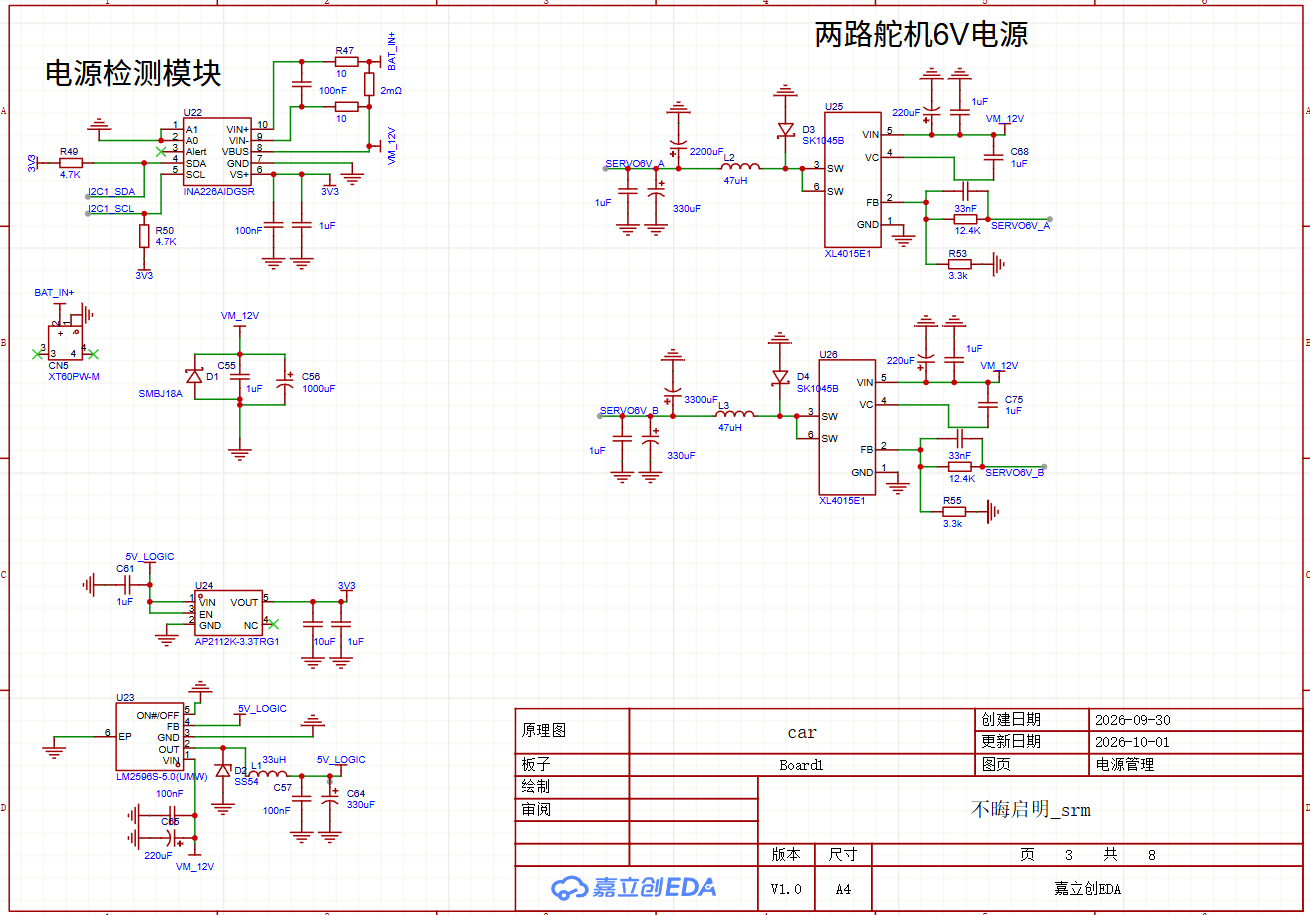
[picture p57: figure]

图表 3 电源管理模块

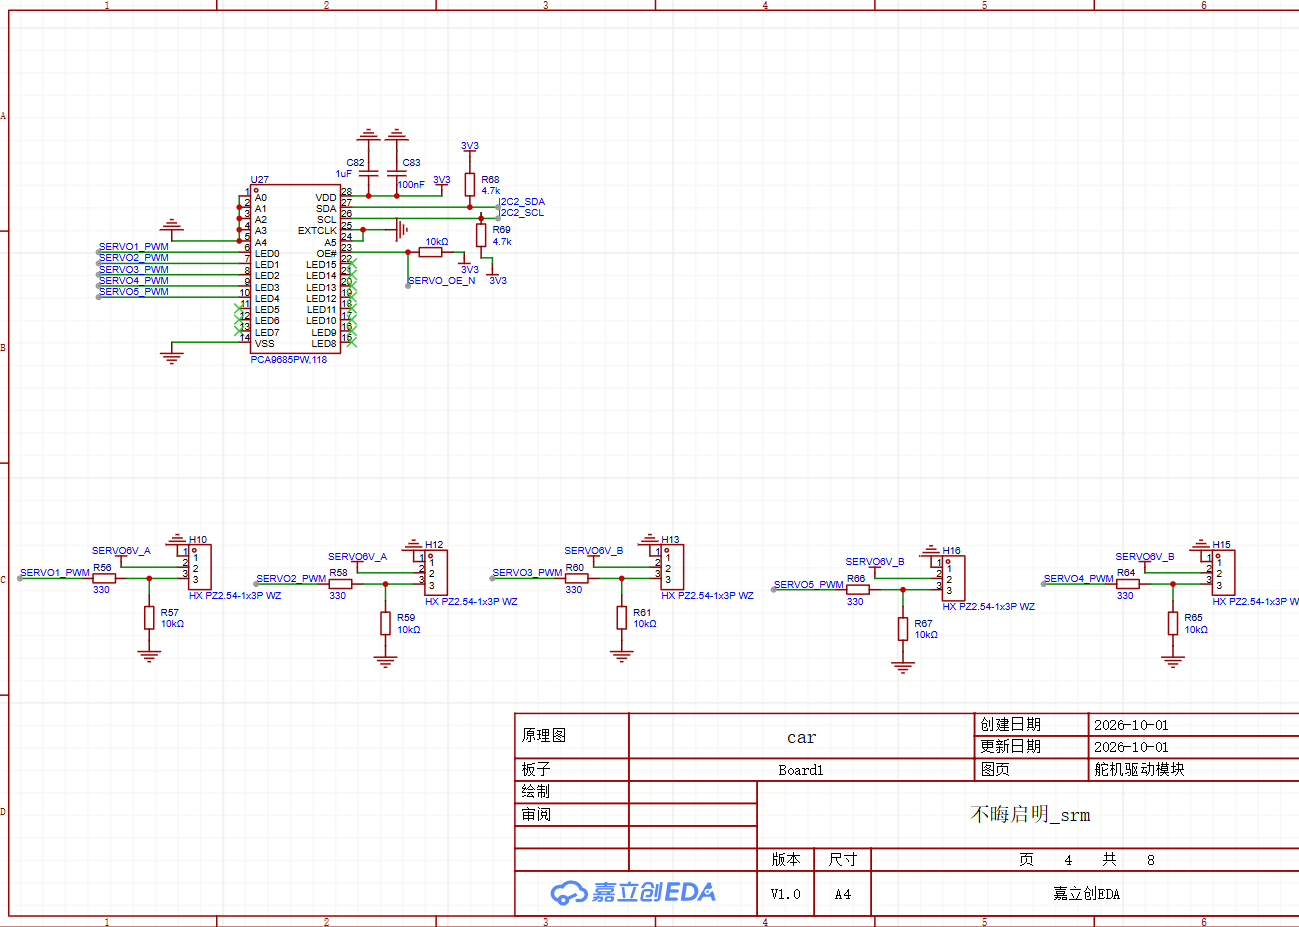
[picture p58: figure]

图表 4 舵机驱动模块


图表 5 无线通讯模块


图表 6 oled模块


图表 7 蜂鸣器和急停


图表 8 串口调试模块

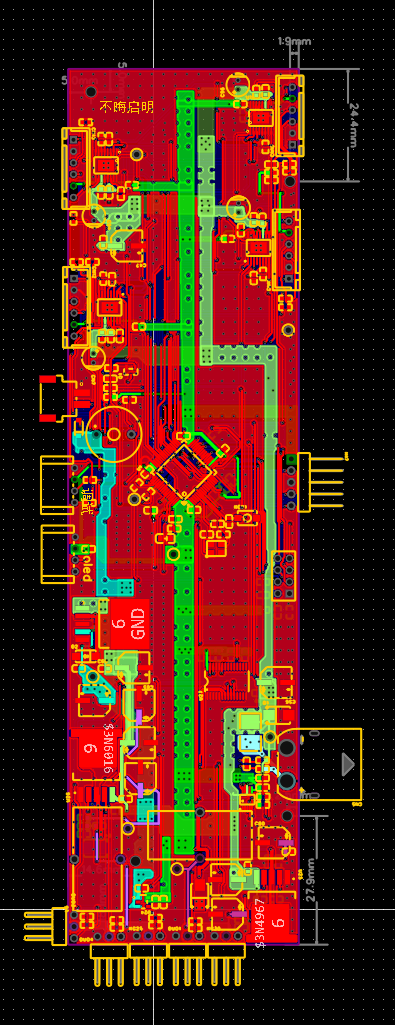
[picture p59: figure]
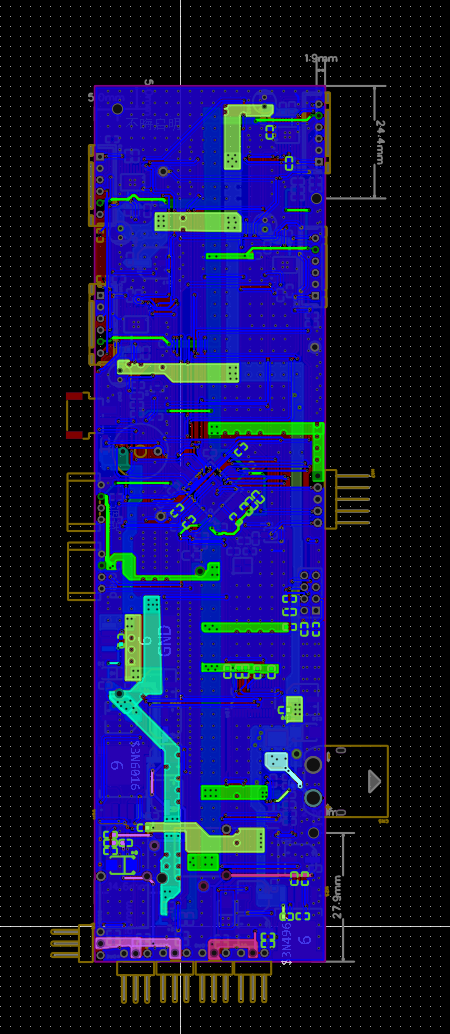
[picture p60: figure]

图表 9 PCB元器件正反面

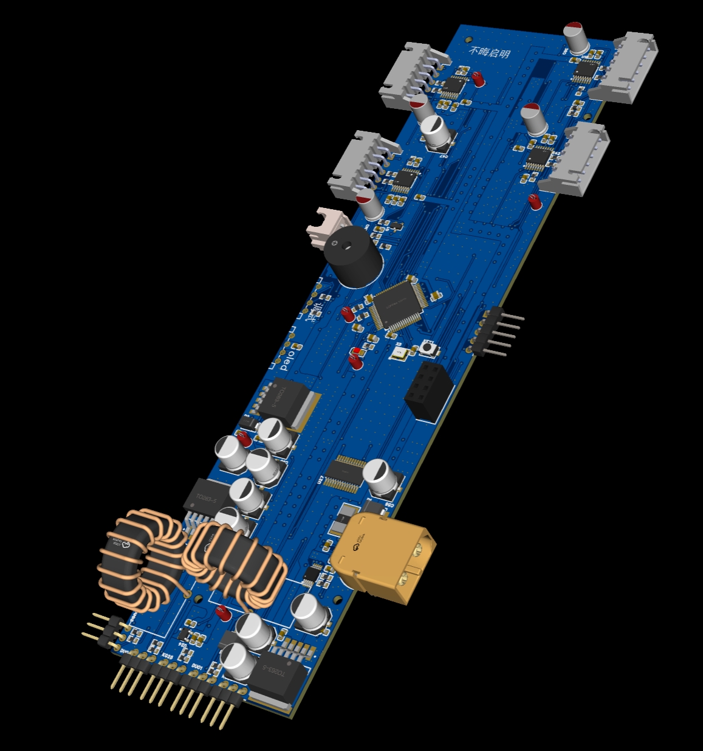
[picture p61: figure]

图表 10 车控主板实物图

遥控部分：


图表 11 MCU

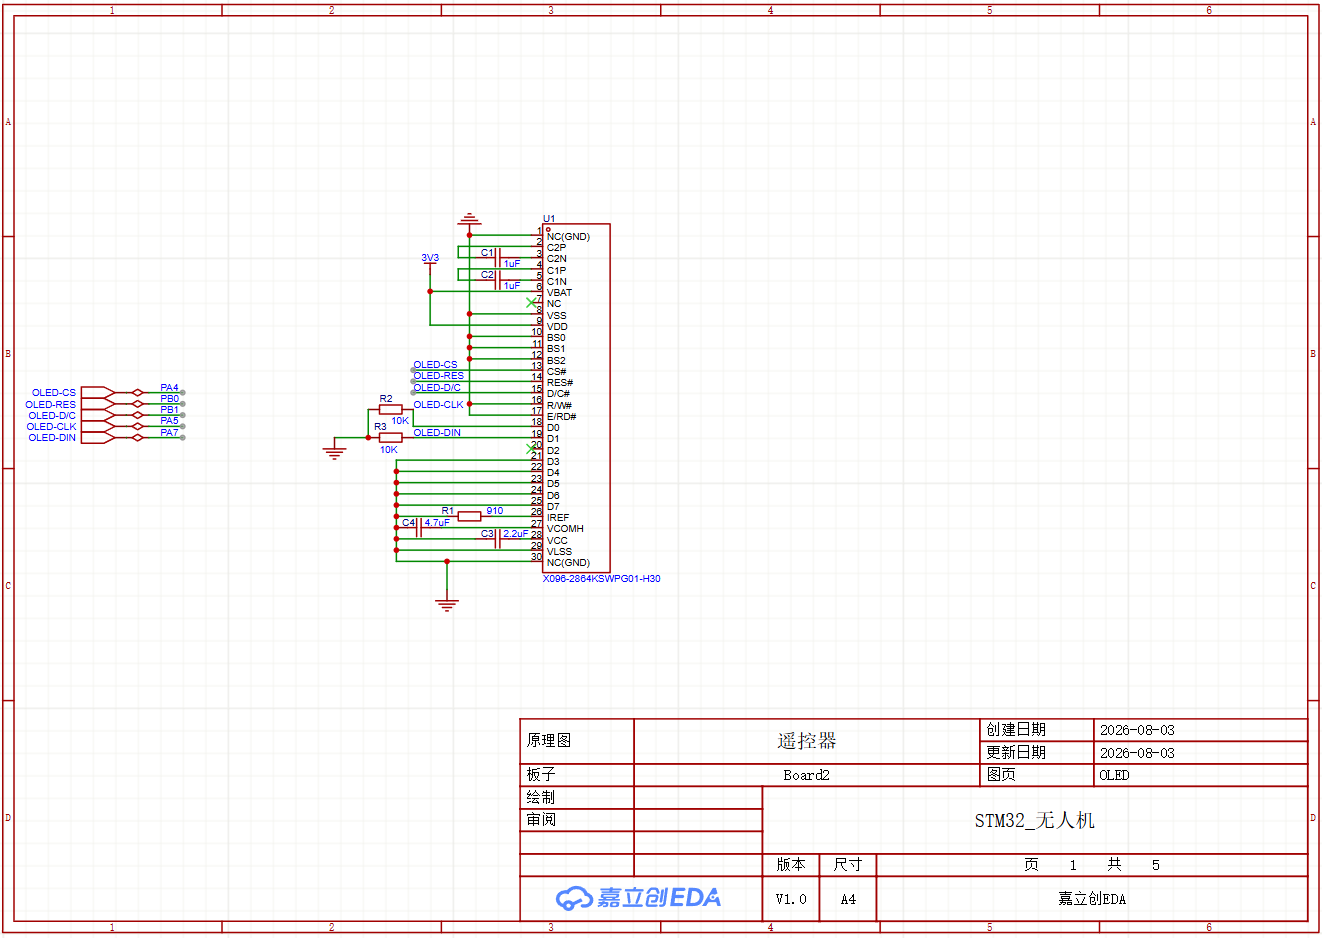
[picture p62: figure]

图表 12 OLED

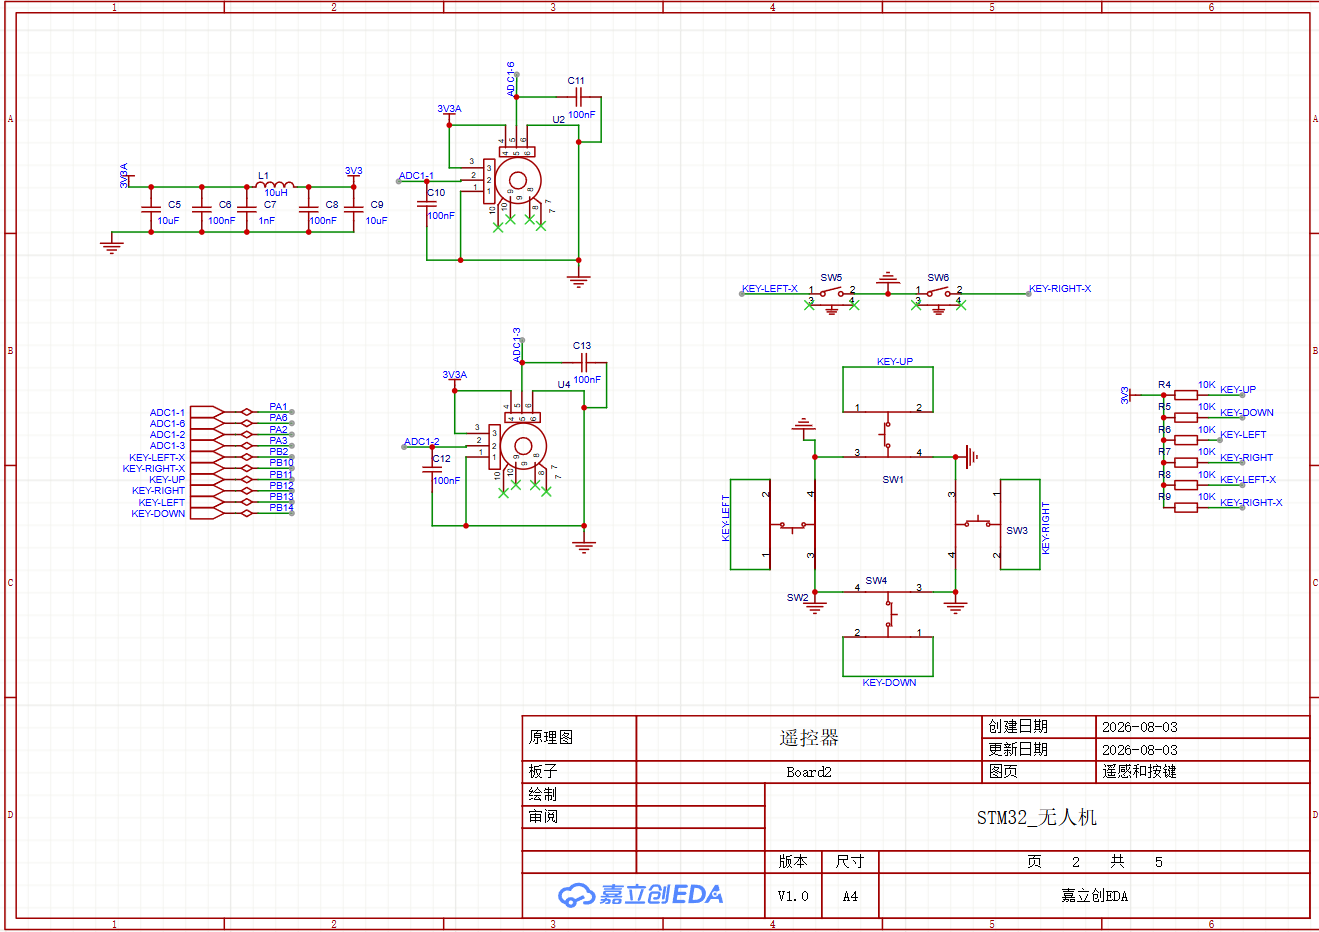
[picture p63: figure]

图表 13 遥控器和按键

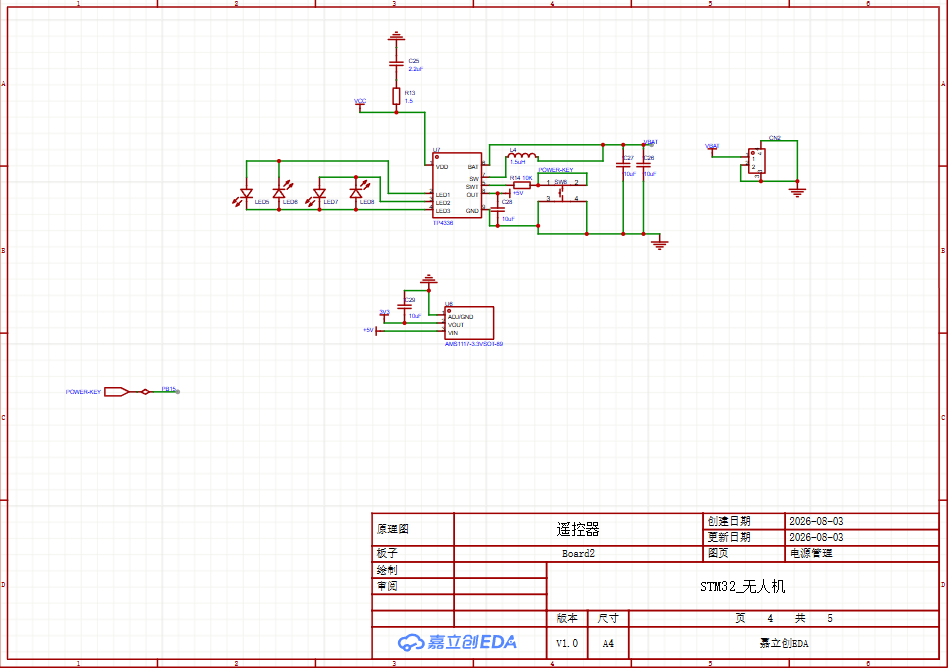
[picture p64: figure]

图表 14 电源管理系统

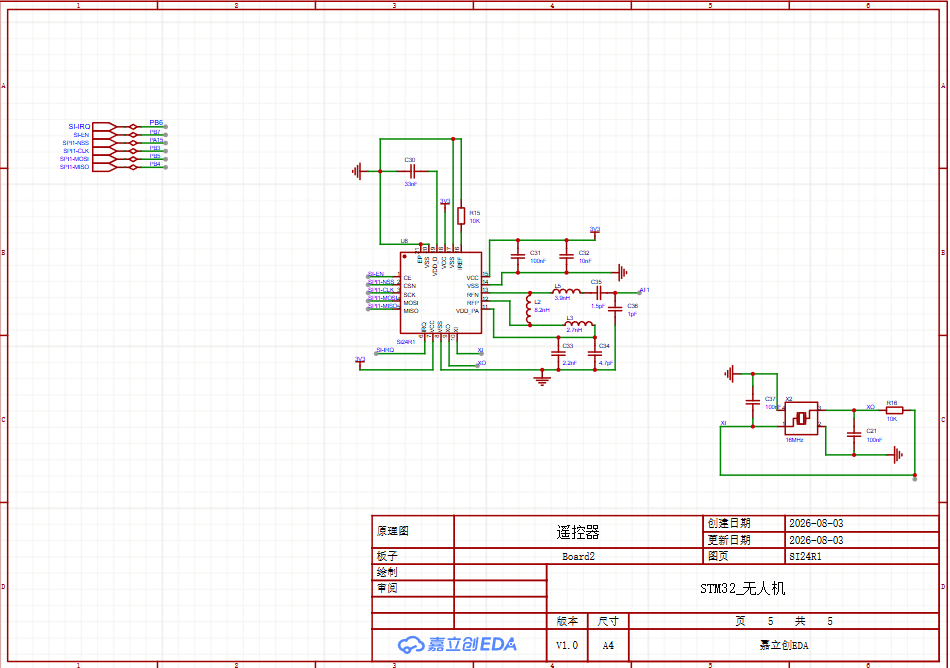
[picture p65: figure]

图表 15 无线

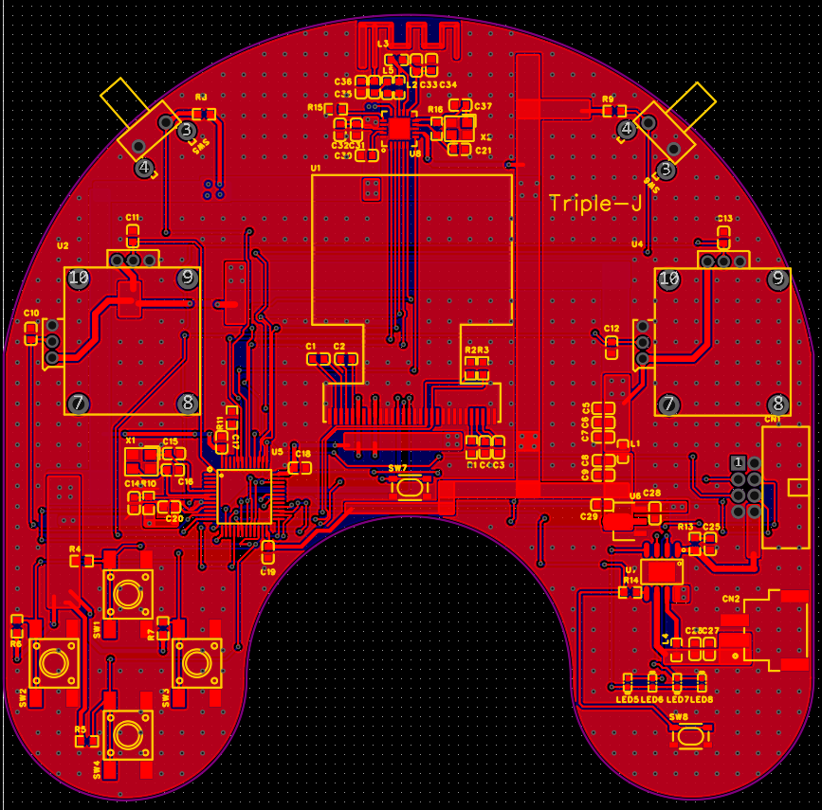
[picture p66: figure]
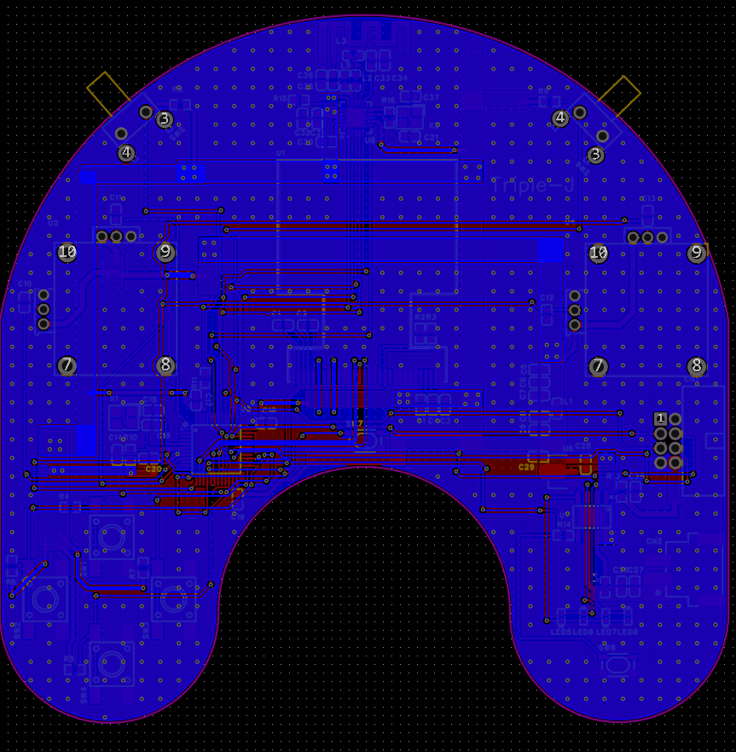
[picture p67: figure]

遥控器PCB顶层 | 遥控器PCB底层

图表 16 遥控器PCB正反


图表 17 遥控器（操作逻辑待进一步确认）

待补：其他所有元器件选型

不晦启明_srm 车控_硬件交付
