AIYAA-1011/buhuiqiming_srm-car/bom/README.md

# A板历史BOM（2026-10-07）

**这不是最终实装采购清单。** 本页转录的是10月7日版；已另行收到10月26日PCB BOM及材料明细，原件直接归档、不改表内数据。表中值按原件保留；乱码不擅自猜测。

原表共57条物料分组，数量合计171件，不含表外机械件和模块。

[下载原始Excel](BOM_Board1_car_2026-10-07.xlsx)

## 新增原始BOM与材料清单

- [2026-10-26 PCB BOM原件](BOM_Board1_PCB1_2026-10-26_1793103483401.xlsx)
- [材料明细原件](材料明细.xlsx)

以下差异说明针对10月7日历史表，不应自动套用于新表。

## 使用前必须核对

- 最终采样电阻为3mΩ；历史表写2mΩ且为R0603，不能按旧表直接采购。后续PCB中位号也有变化。
- L1的L0603及两颗47µH电感的L0603是历史通用封装；降压电源需核对实际功率电感、额定/饱和电流和尺寸，不能按此小信号封装复刻。
- MA35V100M6X8在表中被重复用于100µF、220µF、330µF、1000µF、2200µF、3300µF，型号与标注容量存在冲突，应逐项按实际数据手册和实物确认。
- C91历史选为体积很大的直插电容；是否保留/换型以最终实物为准。
- 蜂鸣器、复位键及调试附件曾讨论不装；原表包含不代表最终安装。
- 电池、五只舵机、电机、无线模块、线束和机械材料需另列整车采购单，不能认为均包含在本表。

## 原表转录

| 序号 | 数量 | 注释 | 位号 | 封装 | 值 | 制造商型号 | 制造商 | 供应商编号 | 供应商 |
| --- | --- | --- | --- | --- | --- | --- | --- | --- | --- |
| 1 | 1 | 2.4kHz | BUZZER1 | BUZ-TH_BD12.0-P7.60-D0.6-FD | 2.4kHz | TMB12A05 | XHXDZ(兴华鑫) | C49246931 | LCSC |
| 2 | 2 | 15pF | C10,C24 | C0603 | 15pF | CC0603JRNPO9BN180 | YAGEO(国巨) |  | LCSC |
| 3 | 23 | 100nF | C14,C15,C16,C17,C18,C28,C33,C38,C43,C45,C48,C49,C50,C51,C52,C53,C57,C60,C83,C84,C88,C89,C90 | C0603 | 100nF |  |  |  |  |
| 4 | 4 | 22nF | C25,C30,C35,C40 | C0603 | 22nF | CL10B223KB8NNNC | SAMSUNG(三星) | C21122 | LCSC |
| 5 | 8 | 100nF | C26,C27,C31,C32,C36,C37,C41,C42 | C0603 | 100nF | CC0603KRX7R9BB104 | YAGEO(国巨) | C14663 | LCSC |
| 6 | 4 | 100uF | C29,C34,C39,C44 | CAP-SMD_BD6.3-L6.6-W6.6-RD | 100uF | MA35V100M6X8 | JIERR(捷而瑞) | C46550467 | LCSC |
| 7 | 13 | 1uF | C46,C54,C55,C61,C62,C66,C68,C69,C73,C75,C76,C82,C85 | C0603 | 1uF |  |  |  |  |
| 8 | 2 | 1000uF | C47,C56 | CAP-SMD_BD6.3-L6.6-W6.6-RD | 1000uF | MA35V100M6X8 | JIERR(捷而瑞) |  | LCSC |
| 9 | 2 | 10uF | C63,C87 | C0603 | 10uF |  |  |  |  |
| 10 | 3 | 330uF | C64,C70,C77 | CAP-SMD_BD6.3-L6.6-W6.6-RD | 330uF | MA35V100M6X8 | JIERR(捷而瑞) |  | LCSC |
| 11 | 3 | 220uF | C65,C67,C74 | CAP-SMD_BD6.3-L6.6-W6.6-RD | 220uF | MA35V100M6X8 | JIERR(捷而瑞) |  | LCSC |
| 12 | 2 | 33nF | C72,C79 | C0603 | 33nF |  |  |  |  |
| 13 | 1 | 2200uF | C80 | CAP-SMD_BD6.3-L6.6-W6.6-RD | 2200uF | MA35V100M6X8 | JIERR(捷而瑞) |  | LCSC |
| 14 | 1 | 3300uF | C81 | CAP-SMD_BD6.3-L6.6-W6.6-RD | 3300uF | MA35V100M6X8 | JIERR(捷而瑞) |  | LCSC |
| 15 | 1 | 4.7uF | C86 | C0603 | 4.7uF |  |  |  |  |
| 16 | 1 | 100nF | C91 | CAP-TH_L18.0-W6.0-P15.00-D1.2 | 100nF | SMQP104K275XXD2B1515 | CHAMPION(全鹏) | C263655 | LCSC |
| 17 | 4 | S6B-XH-A(LF)(SN) | CN1,CN2,CN3,CN4 | CONN-TH_S6B-XH-A-LF-SN |  | S6B-XH-A(LF)(SN) | JST | C157919 | LCSC |
| 18 | 1 | XT60PW-M | CN5 | CONN-TH_XT60PW-M |  | XT60PW-M | AMASS(艾迈斯) | C98732 | LCSC |
| 19 | 2 | HX-XH2.54-4PWZ-B | CN6,CN8 | CONN-TH_HX-XH2.54-4PWZ-B |  | HX-XH2.54-4PWZ-B | hanxia(韩下) | C49010025 | LCSC |
| 20 | 1 | ZX-XH2.54-2PWT | CN7 | CONN-SMD_2P-P2.54_MEGASTAR_ZX-XH2.54-2PWT |  | ZX-XH2.54-2PWT | Megastar(兆星) | C7429671 | LCSC |
| 21 | 1 | SMBJ18A | D1 | SMB_L4.3-W3.6-LS5.3-RD |  | SMBJ18A | Littelfuse(美国力特) | C151256 | LCSC |
| 22 | 1 | SS54 | D2 | SMA_L4.3-W2.6-LS5.0-FD |  | SS54 | R+O(宏嘉诚) | C7420369 | LCSC |
| 23 | 2 | SK1045B | D3,D4 | SMB_L4.3-W3.6-LS5.3-RD |  | SK1045B | R+O(宏嘉诚) | C28646300 | LCSC |
| 24 | 1 | 1N4148W-E3-08 | D10 | SOD-123_L2.8-W1.8-LS3.7-RD |  | 1N4148W-E3-08 | VISHAY(威世) | C241939 | LCSC |
| 25 | 5 | HX PZ2.54-1x3P WZ | DUO1,DUO2,DUO3,DUO4,DUO5 | HDR-TH_3P-P2.54-H-M-W10.4-N |  | HX PZ2.54-1x3P WZ | hanxia(韩下) | C32713262 | LCSC |
| 26 | 1 | HX PZ2.54-1x5P WZ | H17 | HDR-TH_5P-P2.54-H-M-W10.0-N |  | HX PZ2.54-1x5P WZ | hanxia(韩下) | C32713264 | LCSC |
| 27 | 1 | HX PZ2.54-1x2P WZ | H18 | HDR-TH_2P-P2.54-H-M-W9.9 |  | HX PZ2.54-1x2P WZ | hanxia(韩下) | C32713261 | LCSC |
| 28 | 1 | DS1023-2*4SF11 | H19 | HDR-TH_8P-P2.54-V-F-R2-C4-S2.54 |  | DS1023-2*4SF11 | CONNFLY | C92271 | LCSC |
| 29 | 1 | 轻触开关3x4x2 | KEY1 | SW-SMD_L4.0-W2.9-LS5.0 |  | 轻触开关3x4x2 | 国产 | C26638 | LCSC |
| 30 | 1 | 33uH | L1 | L0603 | 33uH |  |  |  |  |
| 31 | 2 | 47uH | L2,L3 | L0603 | 47uH |  |  |  |  |
| 32 | 1 | LED_0805-R | LED1 | LED0805-RD_RED |  |  |  |  |  |
| 33 | 1 | S8050 | Q1 | SOT-23-3_L2.9-W1.3-P1.90-LS2.3-BR |  | S8050 | R+O(宏嘉诚) | C20069125 | LCSC |
| 34 | 1 | 1M | R13 | R0603 | 1M |  |  |  |  |
| 35 | 16 | 10kΩ | R14,R27,R37,R57,R59,R61,R65,R67,R70,R71,R72,R76,R77,R78,R79,R81 | R0603 | 10kΩ | 0603WAF1002T5E | UNI-ROYAL(厚声) | C25804 | LCSC |
| 36 | 1 | 2K | R18 | R0603 | 2K |  |  |  |  |
| 37 | 1 | 30K | R28 | R0603 | 30K |  |  |  |  |
| 38 | 4 | 2.2K | R29,R31,R33,R35 | R0603 | 2.2K |  |  |  |  |
| 39 | 11 | 1K | R39,R40,R41,R42,R43,R44,R45,R46,R83,R84,R85 | R0603 | 1K |  |  |  |  |
| 40 | 3 | 10 | R47,R48,R74 | R0603 | 10 |  |  |  |  |
| 41 | 2 | 4.7K | R49,R50 | R0603 | 4.7K |  |  |  |  |
| 42 | 1 | 2mΩ | R51 | R0603 | 2mΩ |  |  |  |  |
| 43 | 2 | 12.4K | R52,R54 | R0603 | 12.4K |  |  |  |  |
| 44 | 2 | 3.3k | R53,R55 | R0603 | 3.3k |  |  |  |  |
| 45 | 5 | 330 | R56,R58,R60,R64,R66 | R0603 | 330 |  |  |  |  |
| 46 | 2 | 4.7k | R68,R69 | R0603 | 4.7k |  |  |  |  |
| 47 | 1 | 0 | R75 | R0603 | 0 |  |  |  |  |
| 48 | 1 | 1k | R80 | R0603 | 1k |  |  |  |  |
| 49 | 1 | STM32F103RCT6 | U1 | LQFP-64_L10.0-W10.0-P0.50-LS12.0-BL |  | STM32F103RCT6 | ST(意法半导体) | C8323 | LCSC |
| 50 | 4 | DRV8874PWPR | U15,U19,U20,U21 | HTSSOP-16_L5.0-W4.4-P0.65-LS6.4-BL-EP |  | DRV8874PWPR | TI(德州仪器) | C1855818 | LCSC |
| 51 | 1 | INA226AIDGSR | U22 | MSOP-10_L3.0-W3.0-P0.50-LS5.0-BL |  | INA226AIDGSR | TI(德州仪器) | C49851 | LCSC |
| 52 | 1 | LM2596S-5.0(UMW) | U23 | TO-263-5_L10.2-W8.9-P1.70-BR |  | LM2596S-5.0(UMW) | UMW(友台半导体) | C347421 | LCSC |
| 53 | 1 | AP2112K-3.3TRG1 | U24 | SOT-23-5_L2.9-W1.6-P0.95-LS2.8-BR |  | AP2112K-3.3TRG1 | TECH PUBLIC(台舟) | C23380830 | LCSC |
| 54 | 2 | XL4015E1 | U25,U26 | TO-263-5_L10.2-W8.9-P1.70-TL |  | XL4015E1 | XLSEMI(芯龙) | C51661 | LCSC |
| 55 | 1 | PCA9685PW,118 | U27 | TSSOP-28_L9.7-W4.4-P0.65-LS6.4-TL |  | PCA9685PW,118 | NXP(恩智浦) | C2678753 | LCSC |
| 56 | 8 | RH-5000 | U28,U29,U30,U31,U32,U33,U34,U35 | TEST-TH_BD2.54-P1.4_RED |  | RH-5000 | 荣和 | C5277086 | LCSC |
| 57 | 1 | 8MHz | X5 | OSC-SMD_4P-L3.2-W2.5-BL | 8MHz | TAXM8M4RFDCET2T | TAE(雅晶鑫) | C403948 | LCSC |
