AIYAA-1011/buhuiqiming_srm-car/bom/材料明细.xlsx

项目号 | 零件号 | 材料 | 数量 | 总价 | 完成？（1到了，2买了）
1 | 底板^底盘 | 碳纤维 | 1 | 135 | 2
2 | 底盘电机固定板 | 标准件 | 4 | 15.8 | 2
3 | 底盘电机 | 下发 | 4 | 0 | 1
4 | 麦克纳姆轮1 | 下发 | 2 | 0 | 1
5 | 麦克纳姆轮2 | 下发 | 2 | 0 | 1
6 | PMW舵机30,25 | 标准件 | 2 | 85.3 | 2
7 | 金属主舵盘.step | 标准件 | 2 | 0 | 2
8 | 金属副舵盘.step | 标准件 | 2 | 0 | 2
9 | 肩部舵机固定块 | 3D | 1 | 0 | 2
10 | 大臂 | 3d/6061 | 1 | 0 | 2
11 | Mirror大臂 | 3D/6061 | 1 | 0 | 2
12 | 爪体. | 3D | 4 | 0 | 2
13 | 齿轮2 | 3D | 2 | 0 | 2
14 | 连接轴 | 3D | 4 | 0 | 2
15 | 底板2 | 3D | 1 | 0 | 2
16 | 齿轮3 | 3D | 1 | 0 | 2
17 | 爪旋转 | 3D | 1 | 0 | 2
18 | 单轴舵机 | 标准件 | 3 | 35.5 | 2
19 | 金属主舵盘 | 标准件 | 3 | 0 | 2
20 | 底板 | 3D | 1 | 0 | 2
21 | 俯仰支架 | 3D | 1 | 0 | 2
22 | 固定舵机 | 3D | 2 | 0 | 2
23 | 小臂 | 3D/6061 | 1 | 0 | 2
24 | 小臂连接件 | 3D | 1 | 0 | 2
25 | 控制板 | 定制 | 1 | N | N
26 | 矿石仓 | 3D | 1 | 0 | 2
27 | Mirror矿石仓 | 3D | 1 | 0 | 2
28 | 电池 | 下发 | 1 | 0 | 2
29 | Mirror小臂 | 3D/6061 | 1 | 0 | 2
30 | 沉头螺丝，螺丝，锁紧螺母 | 实验室 | 若干 | 0 | 1
31 | 55MM铜柱（M3) | 标准件 | <10 | 7.92 | 2
32 | 紧定螺丝M4 | 实验室 | >5 | 0 | 1
33 | 销钉5*26 | 标准件 | 4 | 2.83 | 2
34 | 销钉6*18 | 标准件 | 2 | 2.69 | 2
35 | 销钉3*6 | 标准件 | 4 | 3.08 | 2
36 | 销钉7*10 | 标准件 | 2 | 2.53 | 2
37 | 销钉3*11 | 标准件 | 2 | 3.66 | 2
 | 总价 |  |  | 294.31
