AIYAA-1011/buhuiqiming_srm-car/hardware/B-unverified/README.md

# B版：备用方案（未经验证）

**未用于比赛，未经实机验证。实际参赛为A版。**

[下载B版嘉立创EDA工程](srm_不晦启明_B.eprj)

工程来自队伍提供的“srm_不晦启明_B.eprj”，源文件修改时间为2026-10-26 18:17，按原文件归档。

相对A版，队伍说明主要调整为：

- 元器件布置更紧密。
- 电源铺铜面积更大。

以上是设计调整说明，不代表电流能力、温升、电源稳定性或通信可靠性已经验证。复现前需在EDA中检查工程、器件与网络，并完成限流上电及负载测试。

[A版参赛资料](../A-competition/) · [硬件交付说明](../../docs/硬件交付.md)
