AIYAA-1011/buhuiqiming_srm-car/(list of files, drawings)

Other design files:
hardware/A-competition/不晦启明_srm A.eprj
hardware/B-unverified/srm_不晦启明_B.eprj
