AIYAA-1011/buhuiqiming_srm-car/software/P02_remote_hal/Core/Src/main.c

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
/* Includes ------------------------------------------------------------------*/
#include "main.h"
#include "adc.h"
#include "dma.h"
#include "spi.h"
#include "usart.h"
#include "gpio.h"

/* USER CODE BEGIN Includes */
#include "App_freeRTOS_Task.h"
#include "Int_SI24R1.h"
#include "App_display.h"
/* USER CODE END Includes */


void SystemClock_Config(void);
/**
  * @brief  The application entry point.
  * @retval int
  */
int main(void)
{

  /* MCU Configuration--------------------------------------------------------*/

  /* Reset of all peripherals, Initializes the Flash interface and the Systick. */
  HAL_Init();

  /* Configure the system clock */
  SystemClock_Config();

  /* Initialize all configured peripherals */
  MX_GPIO_Init();
  MX_DMA_Init();
  MX_USART1_UART_Init();
  MX_SPI1_Init();
  MX_ADC1_Init();
  /* USER CODE BEGIN 2 */

  // 实现最初的日志输出打印
  // HAL_UART_Transmit(&huart2, (uint8_t *)"Hello World!\n", 13, 1000);

  // 使用C语言标准的日志输出功能printf
  debug_printf("Hello remote!\n");

  // 还没有启动freeRTOS  => 此时的延时只能使用HAL_DELAY
  App_display_set_rf(Int_SI24R1_Init() == 0);

  // 启动freeRTOS => 后续的代码都不再执行
  App_freeRTOS_start();


  /* USER CODE END 2 */

  /* Infinite loop */
  /* USER CODE BEGIN WHILE */
  while (1)
  {
    
    /* USER CODE END WHILE */

    /* USER CODE BEGIN 3 */
  }
  /* USER CODE END 3 */
}

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
