AIYAA-1011/buhuiqiming_srm-car/software/Car_Control/Car_Control.ioc

Mcu.UserName=STM32F103RCTx
PA0-WKUP.Signal=S_TIM5_CH1
PA1.Signal=S_TIM5_CH2
PA10.Signal=S_TIM1_CH3
PA11.Signal=S_TIM1_CH4
PA13.Signal=SYS_JTMS-SWDIO
PA14.Signal=SYS_JTCK-SWCLK
PA15.Signal=S_TIM2_CH1_ETR
PA2.Signal=USART2_TX
PA3.Signal=USART2_RX
PA4.GPIO_Label=NRF_CSN
PA4.Signal=GPIO_Output
PA5.Signal=SPI1_SCK
PA6.Signal=SPI1_MISO
PA7.Signal=SPI1_MOSI
PA8.Signal=S_TIM1_CH1
PA9.Signal=S_TIM1_CH2
PB0.GPIO_Label=NRF_CE
PB0.Signal=GPIO_Output
PB1.GPIO_Label=NRF_IRQ
PB1.Signal=GPXTI1
PB10.Signal=I2C2_SCL
PB11.Signal=I2C2_SDA
PB12.GPIO_Label=DIR1
PB12.Signal=GPIO_Output
PB13.GPIO_Label=DIR2
PB13.Signal=GPIO_Output
PB14.GPIO_Label=DIR3
PB14.Signal=GPIO_Output
PB15.GPIO_Label=DIR4
PB15.Signal=GPIO_Output
PB3.Signal=S_TIM2_CH2
PB6.Signal=S_TIM4_CH1
PB7.Signal=S_TIM4_CH2
PB8.Signal=I2C1_SCL
PB9.Signal=I2C1_SDA
PC0.GPIO_Label=ESTOP_ACTIVE
PC0.Signal=GPXTI0
PC10.GPIO_Label=BUZZER
PC10.Signal=GPIO_Output
PC11.GPIO_Label=MOTOR_EN
PC11.Signal=GPIO_Output
PC12.GPIO_Label=SERVO_OE_N
PC12.Signal=GPIO_Output
PC13-TAMPER-RTC.GPIO_Label=Status_Led
PC13-TAMPER-RTC.Signal=GPIO_Output
PC6.Signal=S_TIM3_CH1
PC7.Signal=S_TIM3_CH2
PD0-OSC_IN.Signal=RCC_OSC_IN
PD1-OSC_OUT.Signal=RCC_OSC_OUT
