AIYAA-1011/buhuiqiming_srm-car/software/Car_Control/Core/Inc/main.h

#define Status_Led_Pin GPIO_PIN_13
#define Status_Led_GPIO_Port GPIOC
#define ESTOP_ACTIVE_Pin GPIO_PIN_0
#define ESTOP_ACTIVE_GPIO_Port GPIOC
#define ESTOP_ACTIVE_EXTI_IRQn EXTI0_IRQn
#define NRF_CSN_Pin GPIO_PIN_4
#define NRF_CSN_GPIO_Port GPIOA
#define NRF_CE_Pin GPIO_PIN_0
#define NRF_CE_GPIO_Port GPIOB
#define NRF_IRQ_Pin GPIO_PIN_1
#define NRF_IRQ_GPIO_Port GPIOB
#define NRF_IRQ_EXTI_IRQn EXTI1_IRQn
#define DIR1_Pin GPIO_PIN_12
#define DIR1_GPIO_Port GPIOB
#define DIR2_Pin GPIO_PIN_13
#define DIR2_GPIO_Port GPIOB
#define DIR3_Pin GPIO_PIN_14
#define DIR3_GPIO_Port GPIOB
#define DIR4_Pin GPIO_PIN_15
#define DIR4_GPIO_Port GPIOB
#define BUZZER_Pin GPIO_PIN_10
#define BUZZER_GPIO_Port GPIOC
#define MOTOR_EN_Pin GPIO_PIN_11
#define MOTOR_EN_GPIO_Port GPIOC
#define SERVO_OE_N_Pin GPIO_PIN_12
#define SERVO_OE_N_GPIO_Port GPIOC
