AIYAA-1011/buhuiqiming_srm-car/software/P02_remote_hal/MDK-ARM/Application/App_command.h

#ifndef __APP_COMMAND__
#define __APP_COMMAND__

#include "Int_key.h"
#include "App_process_data.h"
#include "Com_debug.h"
#include "FreeRTOS.h"
#include "task.h"

/* 屏幕行1 最右一格显示的状态字母，永远只显示一个 */
#define CMD_ACTION_NONE  ' '
#define CMD_ACTION_HOLE  'H' /* 过洞 */
#define CMD_ACTION_PICK  'P' /* 取矿 */
#define CMD_ACTION_PUT   'D' /* 兑矿 */
#define CMD_ACTION_ESTOP 'E' /* 急停，反白显示 */

/* 预设姿态编号 */
#define CMD_PRESET_NONE 0
#define CMD_PRESET_HOLE 1
#define CMD_PRESET_PICK 2
#define CMD_PRESET_PUT  3

/**
 * @brief 遥控器命令状态：按键产生，发送层取用
 */
typedef struct
{
    uint8_t mode;    /* MODE_CHASSIS / MODE_ARM */
    uint8_t armed;   /* 0 = 冻结输出（等摇杆回中），1 = 允许输出 */
    uint8_t estop;   /* 1 = 急停锁定 */
    uint8_t gripper; /* 1 = 夹爪夹紧，0 = 张开 */
    uint8_t preset;  /* CMD_PRESET_xxx */
    char    action;  /* 屏幕上显示的字母 */
} Command_Data;

extern Command_Data cmd;

/**
 * @brief 初始化命令状态
 */
void App_command_init(void);

/**
 * @brief 扫描按键并处理事件（key_task 里每 20ms 调一次）
 *        全程非阻塞：按住任何键都不会影响其它键，急停按下即生效
 *
 * 三个预设姿态是互锁的：已经有预设时，按"别的"预设键会被忽略，
 * 并把当前状态字母闪 2 下（约 800ms）作为反馈。必须先按同一个键
 * （或者推一下摇杆让操作员接管）取消，才能启动另一个预设。
 */
void App_command_scan(void);

/**
 * @brief 取当前应该发给小车的四个轴值
 *
 * 未解锁（还在等摇杆回中）或者急停锁定时，四个轴一律输出 0。
 * 这样切模式的瞬间不会把旧模式的杆位当成新模式的命令发出去。
 *
 * @param out 长度 4 的数组，顺序 ly / lx / ry / rx
 */
void App_command_get_output(int16_t *out);

#endif // __APP_COMMAND__
