AIYAA-1011/buhuiqiming_srm-car/software/P02_remote_hal/MDK-ARM/Application/App_display.h

#ifndef __APP_DISPLAY__
#define __APP_DISPLAY__

#include "Inf_OLED.h"
#include "Int_SI24R1.h"
#include "App_process_data.h"

/* ===================== 屏幕布局 =====================
 * OLED 128x64，使用 8x12 的 ASCII 字体，每行正好 16 个字符
 *
 *   行1 (y=0)   LNK 98%         E     链路成功率 + 状态字母
 *   行2 (y=14)  MECANUM READY          当前模式 + 是否已解锁
 *   行3 (y=26)  左摇杆Y         右摇杆Y
 *   行4 (y=38)  左摇杆X         右摇杆X
 *
 * 左边一列 = 左摇杆的两个轴，右边一列 = 右摇杆的两个轴。
 * 具体标签随「模式」和「是否解锁」变化：
 *
 *   未解锁    LY 左杆Y | RY 右杆Y
 *             LX 左杆X | RX 右杆X
 *
 *   底盘      -- 不使用 | VX 前后
 *             W  自转   | VY 左右
 *
 *   机械臂    BM 大臂   | WP 腕部俯仰
 *             EX 小臂   | WR 腕部转动
 *
 * 轴值域 -500 ~ +500，0 表示中位/停止，死区内显示 "----"
 * 状态字母永远只显示一个，放在行1 最右一格
 * ==================================================== */
#define LINE1_Y 0
#define LINE2_Y 14
#define LINE3_Y 26
#define LINE4_Y 38

/* 状态字母 */
#define ACT_NONE  ' '
#define ACT_HOLE  'H' /* 过洞 */
#define ACT_PICK  'P' /* 取矿 */
#define ACT_PUT   'D' /* 兑矿 */
#define ACT_ESTOP 'E' /* 急停，反白显示 */

/**
 * @brief 屏幕显示数据
 *        各模块只管往这里写，显示层只负责画出来
 */
typedef struct
{
    uint8_t rf_ok;        /* 1 = 无线模块自检通过 */
    uint8_t link_valid;   /* 1 = 收到过 ACK，link_percent 有效 */
    uint8_t link_percent; /* 0-100，发送成功率 */
    uint8_t mode;         /* MODE_CHASSIS / MODE_ARM */
    uint8_t armed;        /* 1 = 已解锁（摇杆已回中） */
    int16_t axis[4];      /* -500 ~ +500，顺序 ly / lx / ry / rx */
    char    action;       /* 状态字母 ACT_xxx */
} Ui_Data;

extern Ui_Data ui_data;

/**
 * @brief 初始化 OLED 硬件
 */
void App_display_init(void);

/**
 * @brief 记录无线模块自检结果（由 main 在启动 RTOS 之前调用）
 */
void App_display_set_rf(uint8_t ok);

/**
 * @brief 开机自检画面（oled_task 启动时调一次，内部带延时）
 */
void App_display_boot(void);

/**
 * @brief 循环执行刷写屏幕
 */
void App_display_show(void);

/**
 * @brief 进度条（字库里有 13 级进度条字模，需要时直接调用）
 * @param x 起始列  y 起始行  count 0-12
 */
void App_display_show_bar(uint8_t x, uint8_t y, uint8_t count);

#endif // __APP_DISPLAY__
