AIYAA-1011/buhuiqiming_srm-car/(commit log)

2026-10-11 小车引脚修改
2026-10-11 遥控器按键功能修改，取消阻塞
2026-10-11 遥控器按键处理（减零偏，限幅，死区，回中解锁），修改显示格式
2026-10-11 遥控器修改数据包，删除回传机制，改为常驻发送，增加发送成功率显示
2026-10-11 遥控器摇杆运动解除预制模式，增加一层零偏范围，重新校准时清零偏，修改变量名
2026-10-11 删了一些备份
2026-10-14 增加遥控器说明
2026-10-14 排除临时文件
2026-10-14 遥控器说明
2026-10-15 修改遥控器按键逻辑，ly死区
2026-10-23 小车初始化user目录，调整FreeRTOS配置
2026-10-23 小车无线通信模块
2026-10-23 小车机械臂角度限制
2026-10-27 小车遥控机械臂、夹爪开合、限速
2026-10-29 小车ina226、oled驱动；显示电流电压电量
2026-10-29 舵机驱动通道修改
2026-10-29 小车通信接收标志
2026-10-30 电机驱动
2026-10-30 解算+调pid
2026-10-30 遥控控制电机
2026-10-30 提高底盘最大速度
2026-10-30 增加预制过洞模式
2026-10-31 调换车头方向，调整机械臂俯仰极性
2026-10-31 预制放矿
2026-10-31 遥控器操作修改
2026-10-31 调整机械臂角度
2026-11-02 限制腕旋转+改信道
2026-11-02 增加小车说明
2026-11-02 docs: record competition delivery, A-board configuration and team contributions
2026-11-02 docs: confirm final 3 milliohm current shunt
2026-11-02 docs: confirm MG945 servos, connector failure and named team credits
2026-11-02 Update README to remove BOM section
    Removed historical BOM transcription and procurement differences note from README.
2026-11-05 Update U24 issue conclusion in README
    Clarified the conclusion regarding U24-related low resistance and power drop issues.
