AIYAA-1011/buhuiqiming_srm-car/(notices)

Notices in the files:
software/P02_remote_hal/Core/Src/main.c:
Copyright (c) 2025 STMicroelectronics.
All rights reserved.
This software is licensed under terms that can be found in the LICENSE file
software/Car_Control/Core/Inc/main.h:
Copyright (c) 2026 STMicroelectronics.
